Rat-Rig/V-Minion/README.md

# Rat Rig V-Minion

## Links
[CAD (Fusion 360)](https://a360.co/3rPymJS)

[Project Page](https://v-minion.ratrig.com/)

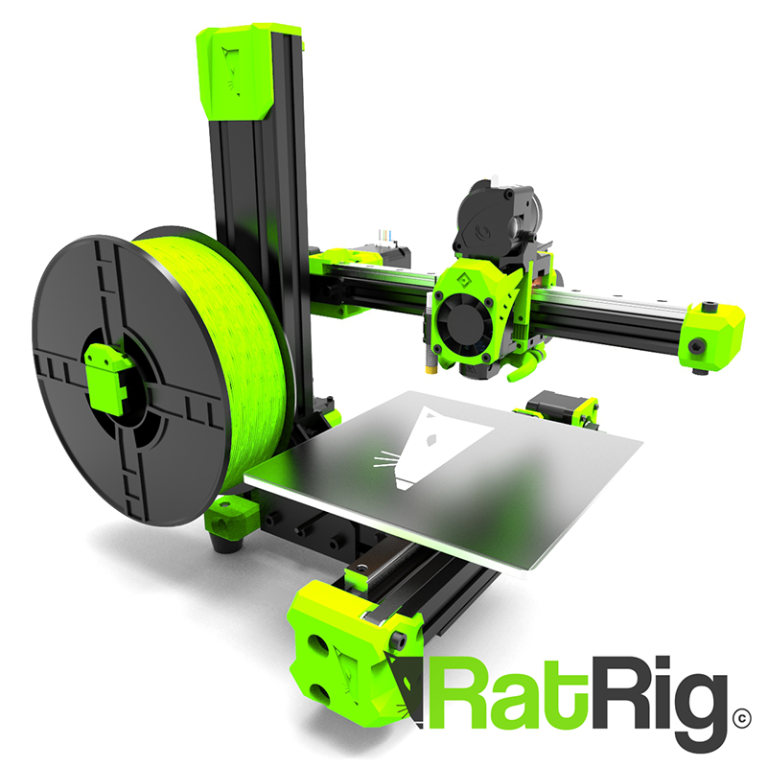
[picture p1: docs/src/assets/splash.png]
