Rat-Rig/V-Minion/cad/panels/README.md

# Electronics Enclosure panels

This subdirectory contains the source files for the four panels used on the V-Minion electronics enclosure.

# Formats
## DXF
For laser cutting, industry standard DXF files are provided. Both metric (millimeters) and imperial (inches) versions are available.

> **Please note:** The dimensions in the DXF files are exact. No provision for laser kerf has been provided as this varies greatly depending on the material being cut, the laser cutter being used, and / or the operator of the machine.

## STEP
For CNC routing, or CAD applications, industry standard STEP files are provided. Both metric (millimeters) and imperial (inches) versions are available.

## STL
For 3D printing your own panels. Metric (millimeters) versions are available.
