Rat-Rig/V-Minion/docs/src/electronics.md

---
title: Electronics
hide:
  - navigation
---

The default V-Minion configuration comes supplied with either an SKRat 1.0, SKR2, or Octopus 1.1 mainboards from BIGTREETECH. Rat Rig provide detailed wiring diagrams for these configurations.

## BIGTREETECH SKRat 1.0 Wiring Diagram

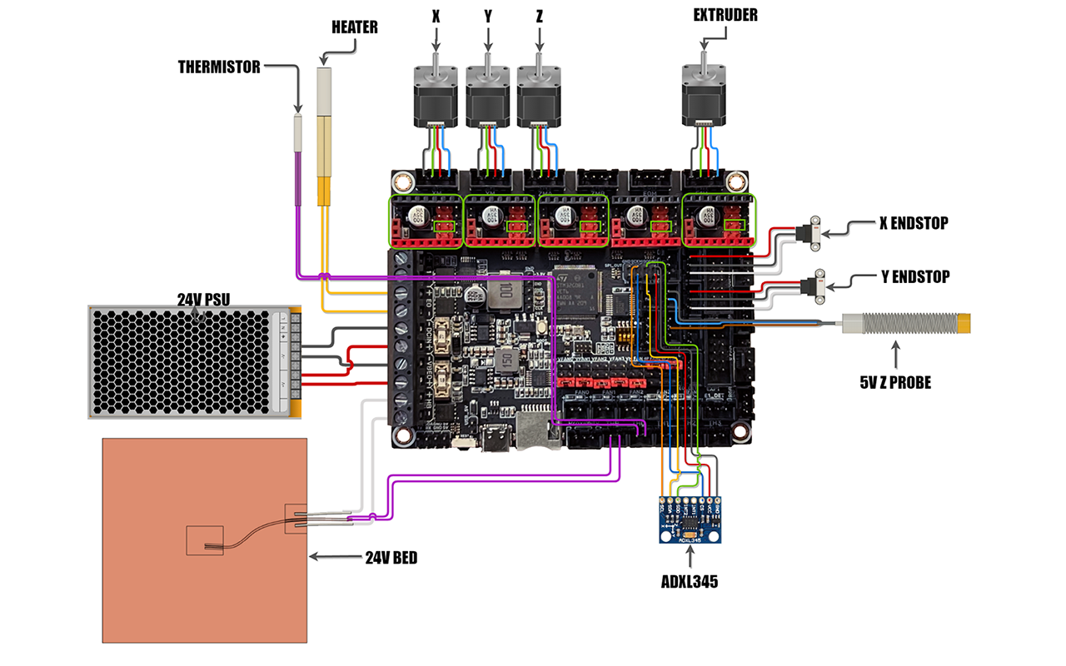
[picture p2: docs/src/assets/wiring_skrat_thumb.png]


<center>[:material-magnify-plus: Click here to view the full size wiring diagram](/assets/wiring_skrat.png){: .md-button .md-button--primary target=_blank}</center>

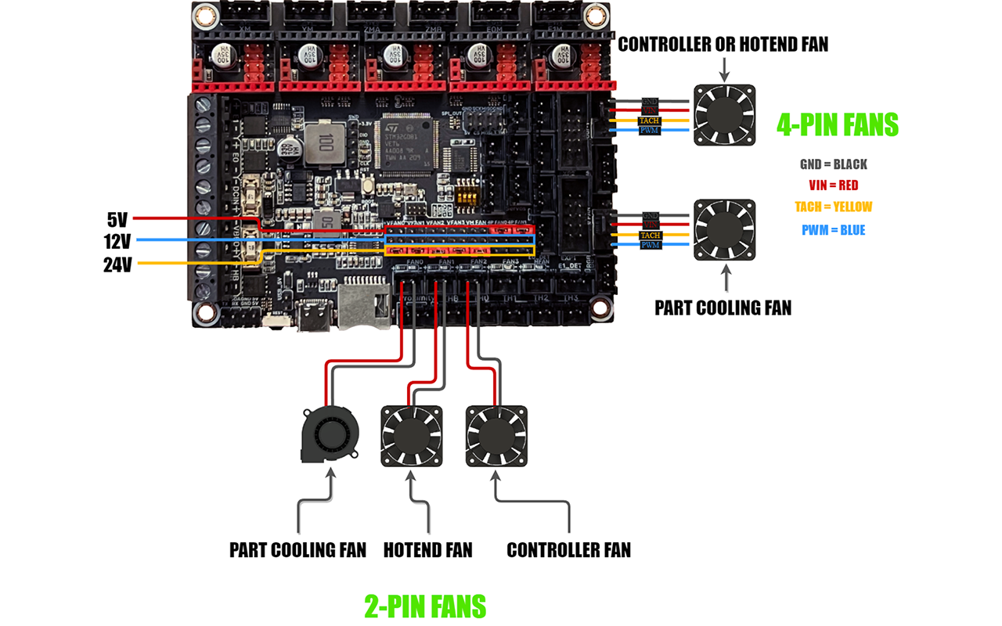
[picture p3: docs/src/assets/wiring_skrat_fan_thumb.png]


<center>[:material-magnify-plus: Click here to view the full size wiring diagram](/assets/wiring_skrat_fan.png){: .md-button .md-button--primary target=_blank}</center>

## BIGTREETECH Octopus 1.1 Wiring Diagram

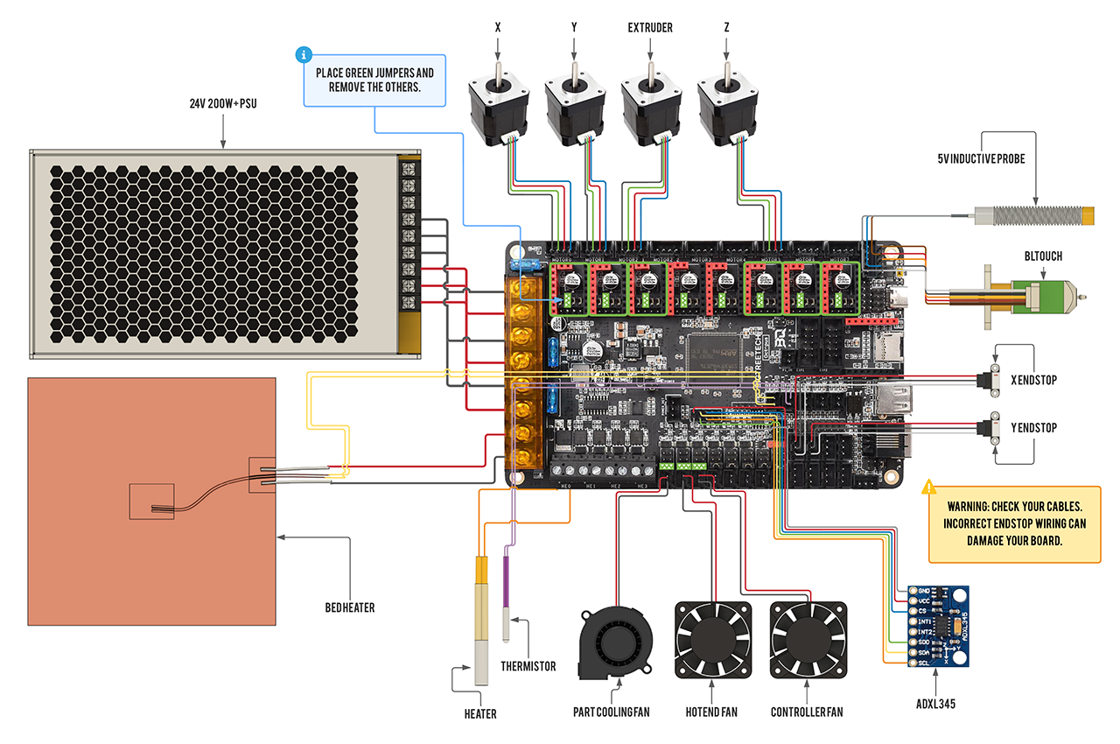
[picture p4: docs/src/assets/wiring_octopus_thumb.png]


<center>[:material-magnify-plus: Click here to view the full size wiring diagram](/assets/wiring_octopus.png){: .md-button .md-button--primary target=_blank}</center>

## BIGTREETECH SKR2 Wiring Diagram

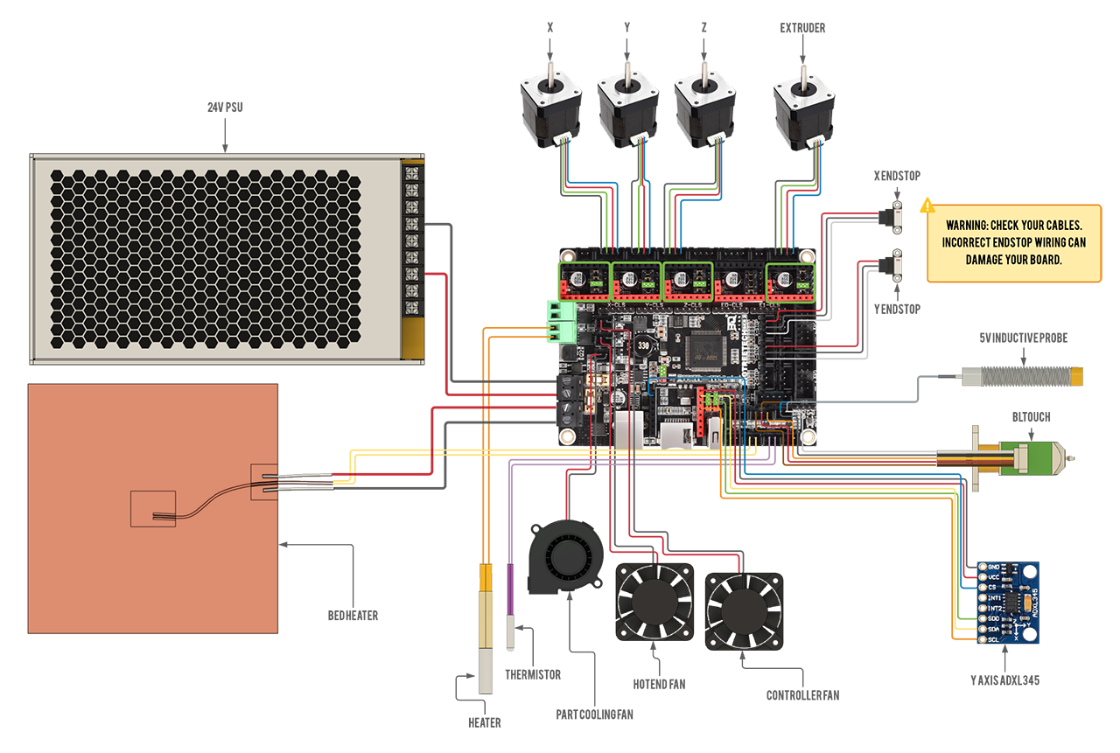
[picture p5: docs/src/assets/wiring_skr2_thumb.png]


<center>[:material-magnify-plus: Click here to view the full size wiring diagram](/assets/wiring_skr2.png){: .md-button .md-button--primary target=_blank}</center>

## Powering the Raspberry Pi from the SKR2
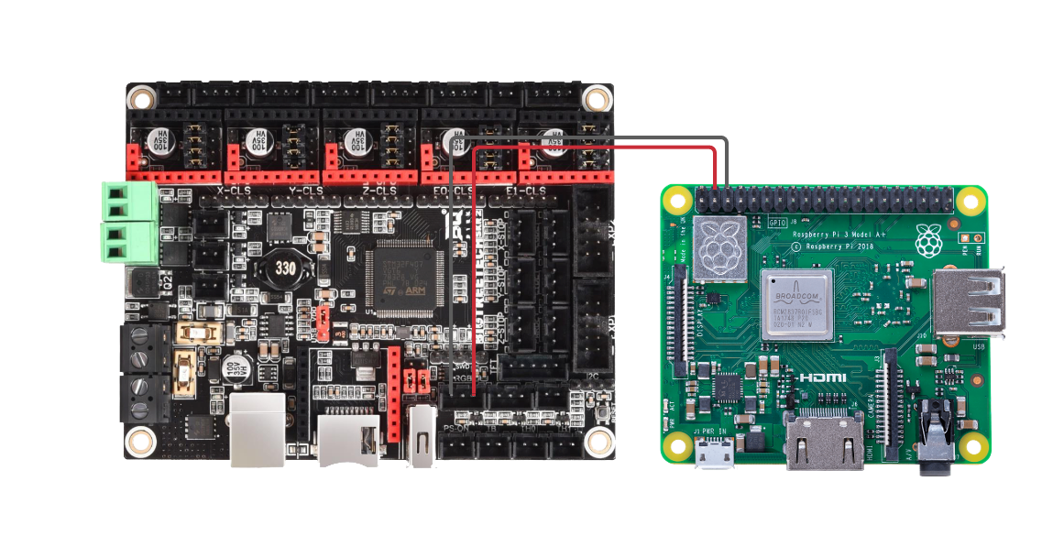
[picture p6: docs/src/assets/wiring_skr2_pi_power.png]
