Rat-Rig/V-Minion/docs/src/slicer.md

---
title: Slicer
hide:
  - navigation
---

## SuperSlicer
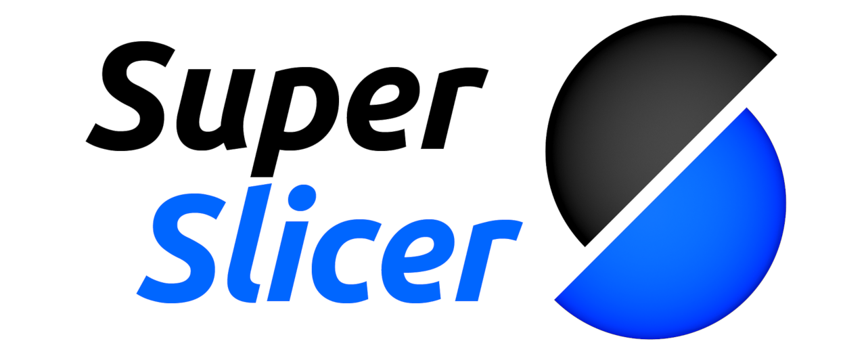
[picture p25: docs/src/assets/superslicer_logo.png]

Detlev Rackow, a member of Rat Rig's Beta/Dev team, provides SuperSlicer profiles for the V-Minion in its stock configuration. As of version 2.3.57 these profiles are not included with SuperSlicer, and must be installed manually, but are planned to be intergrated in a future version.

### Obtaining SuperSlicer
SuperSlicer is a free and open-source project. It can be obtained directly from their [:material-github: GitHub repository](https://github.com/supermerill/SuperSlicer/releases)

### Configuring SuperSlicer for the V-Minion
The following video gives an overview on configuring SuperSlicer to connect with your V-Minion:
<center><iframe width="1000" height="600" src="https://www.youtube.com/embed/5o2UqtdWnn0" frameborder="0" allow="accelerometer; autoplay; clipboard-write; encrypted-media; gyroscope; picture-in-picture" allowfullscreen></iframe></center>
