Rat-Rig/V-Minion/docs/src/firmware.md

---
title: Firmware
hide:
  - navigation
---

## RatOS
RatOS is developed and maintained by Mikkel Schmidt (a member of Rat Rig's Beta/Dev team). It combines the power of the Klipper firmware, as well as several other open-source projects, to provide a stable and easy-to-use operating system for all your printing needs.
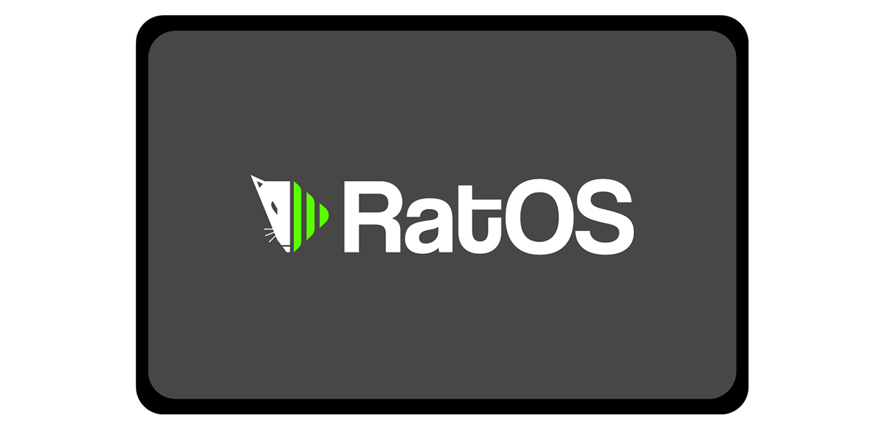
[picture p26: docs/src/assets/ratos_logo.png]


<center>[:material-link-box-variant: Official RatOS documentation](https://os.ratrig.com/){: .md-button .md-button--primary}</center>
