Rat-Rig/V-Minion/docs/src/assets/360/main/1.png

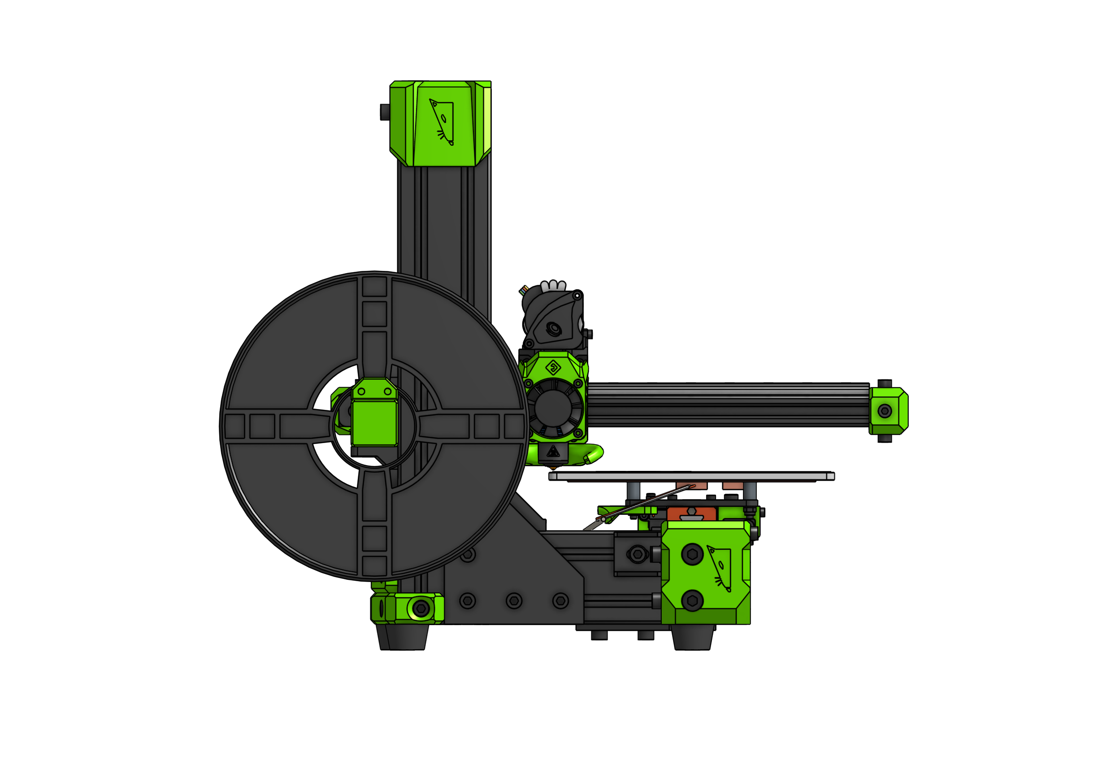
docs/src/assets/360/main/1.png
