Rat-Rig/V-Minion/docs/src/assets/360/main/3.png

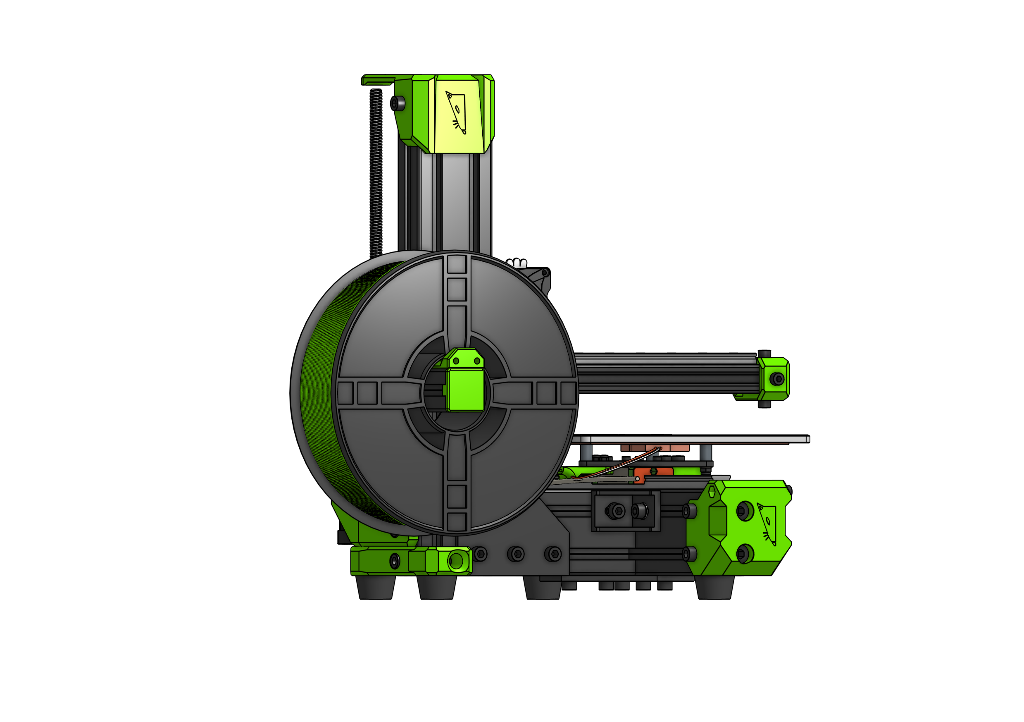
docs/src/assets/360/main/3.png
