Rat-Rig/V-Minion/docs/src/assets/360/main/4.png

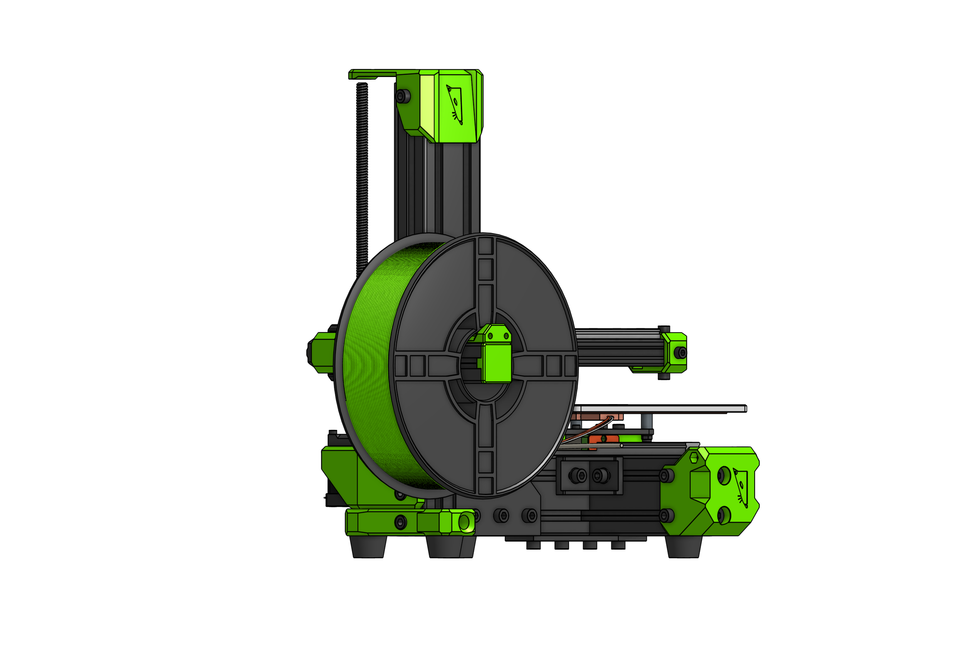
docs/src/assets/360/main/4.png
