Rat-Rig/V-Minion/docs/src/assets/360/main/5.png

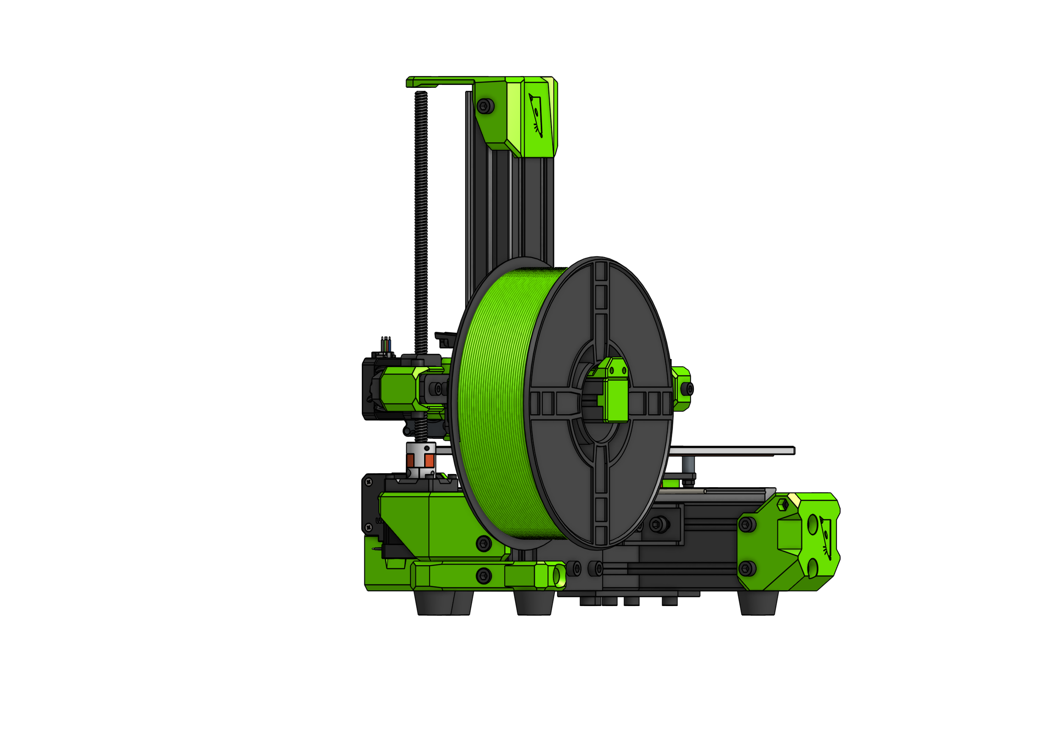
docs/src/assets/360/main/5.png
