Rat-Rig/V-Minion/docs/src/assets/360/main/6.png

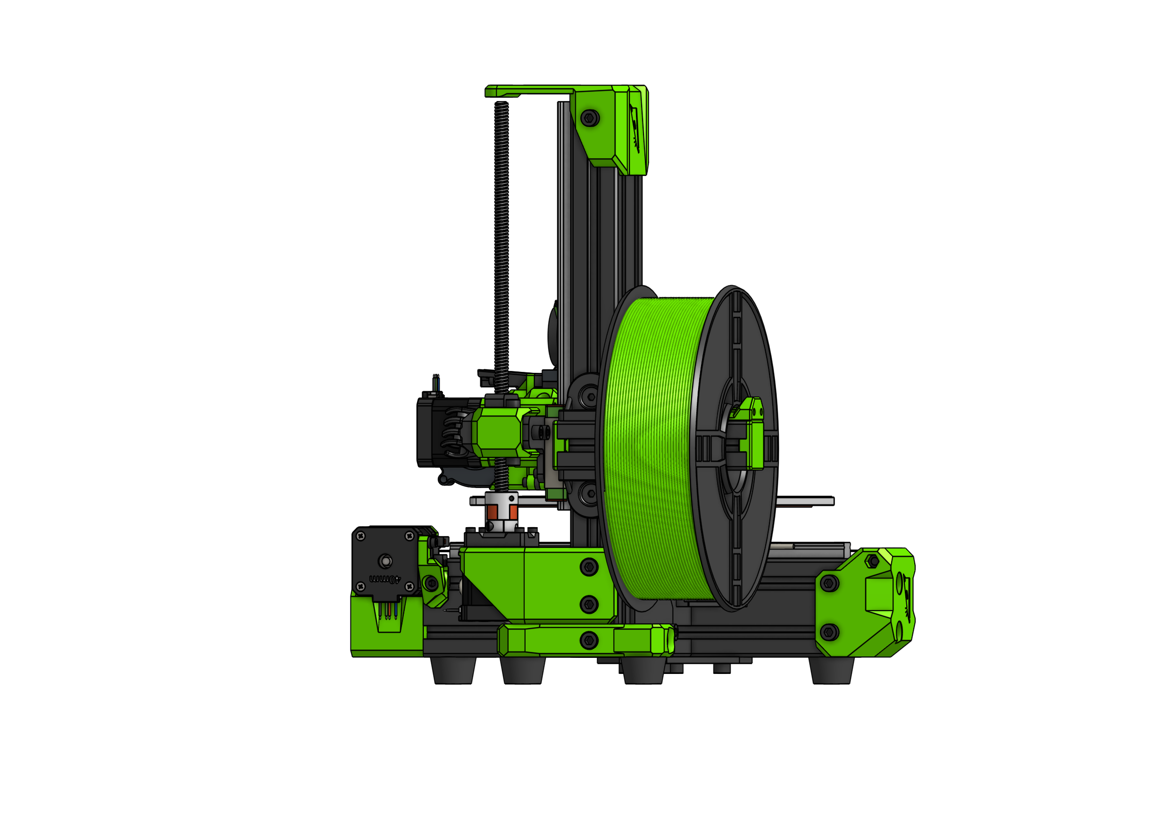
docs/src/assets/360/main/6.png
