Rat-Rig/V-Minion/docs/src/assets/360/main/7.png

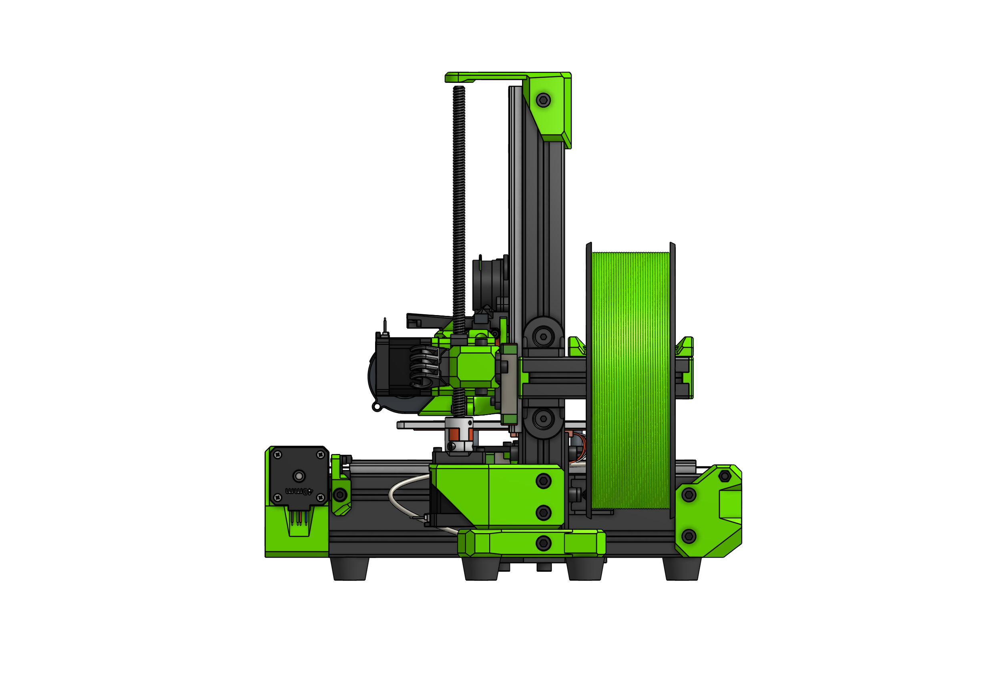
docs/src/assets/360/main/7.png
