Rat-Rig/V-Minion/docs/src/assets/360/main/8.png

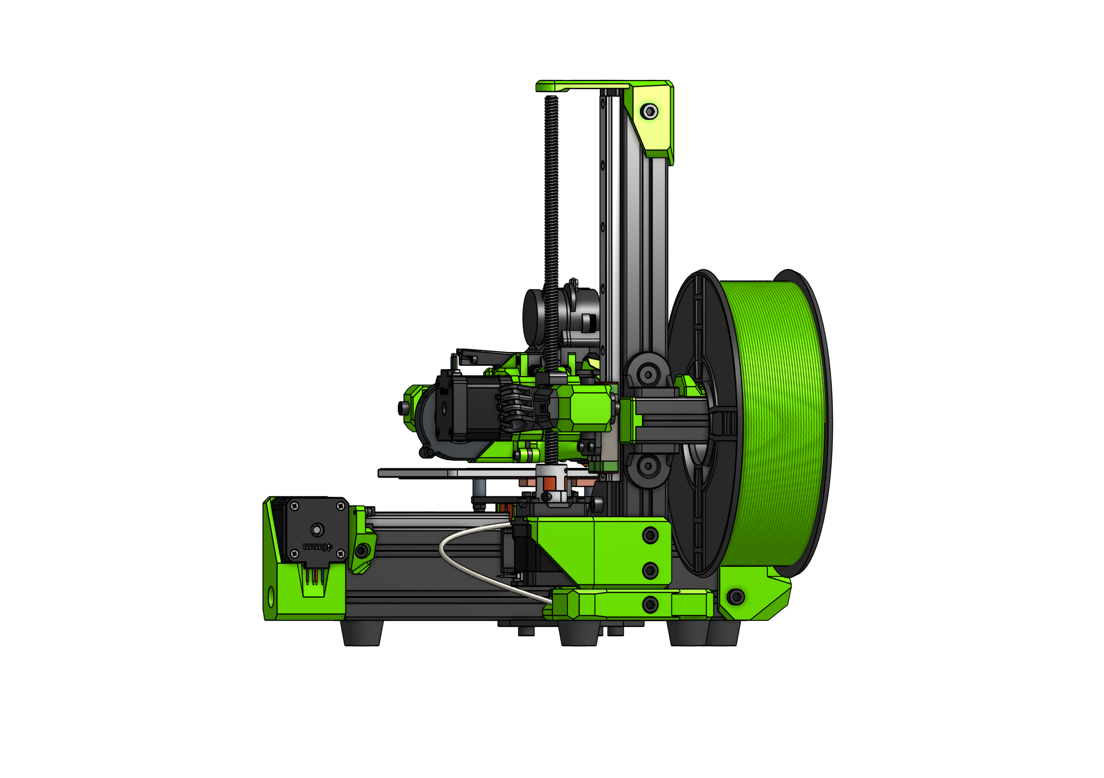
docs/src/assets/360/main/8.png
