Rat-Rig/V-Minion/docs/src/assets/360/main/9.png

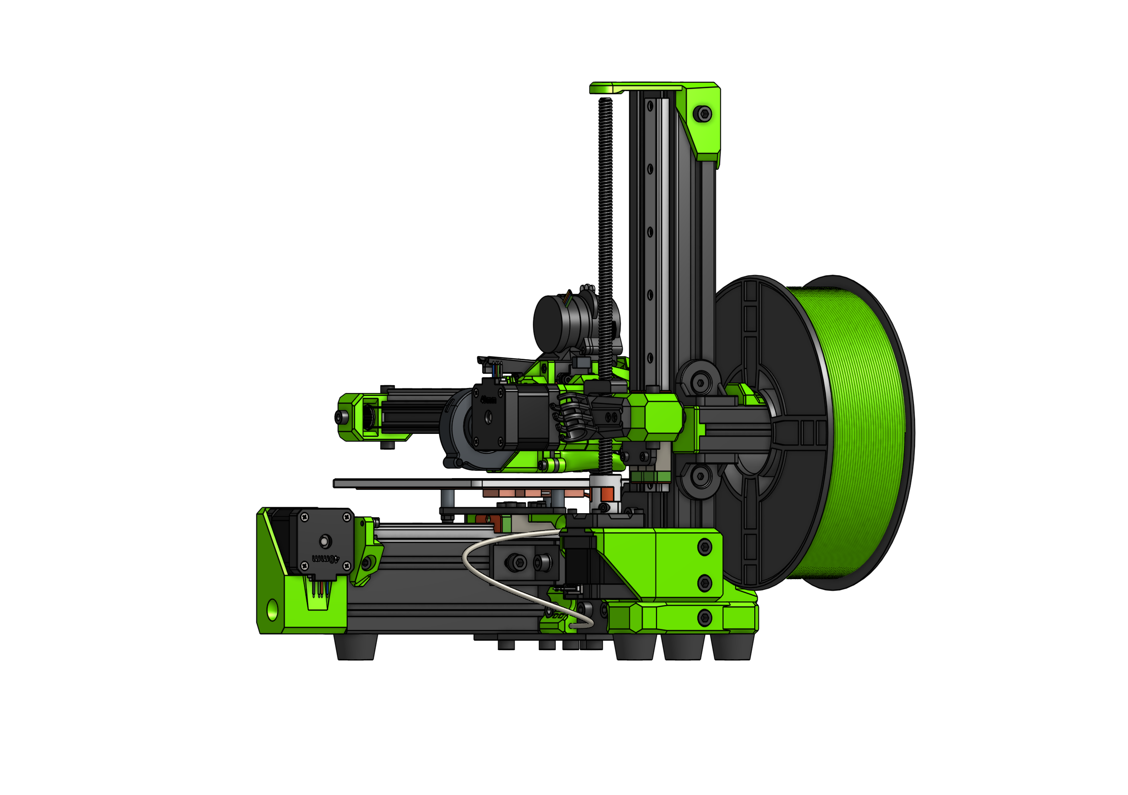
docs/src/assets/360/main/9.png
