Rat-Rig/V-Minion/docs/src/assets/360/main/10.png

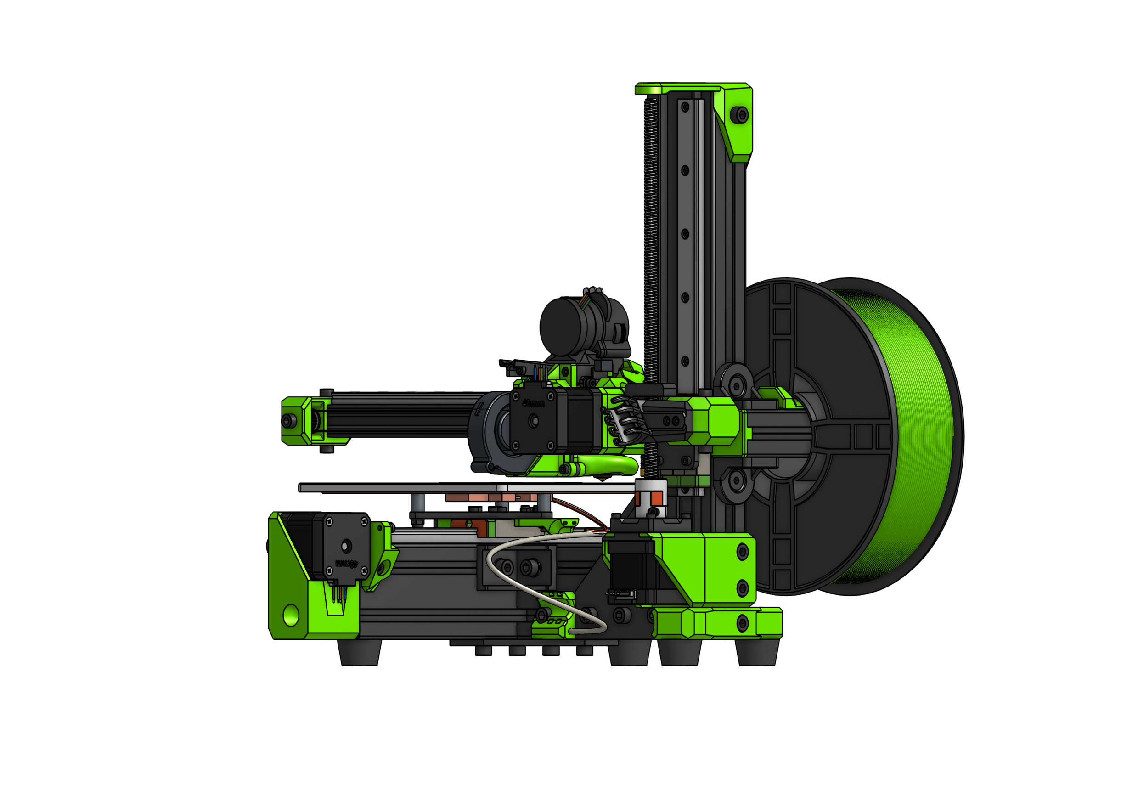
docs/src/assets/360/main/10.png
