Rat-Rig/V-Minion/docs/src/assets/360/main/11.png

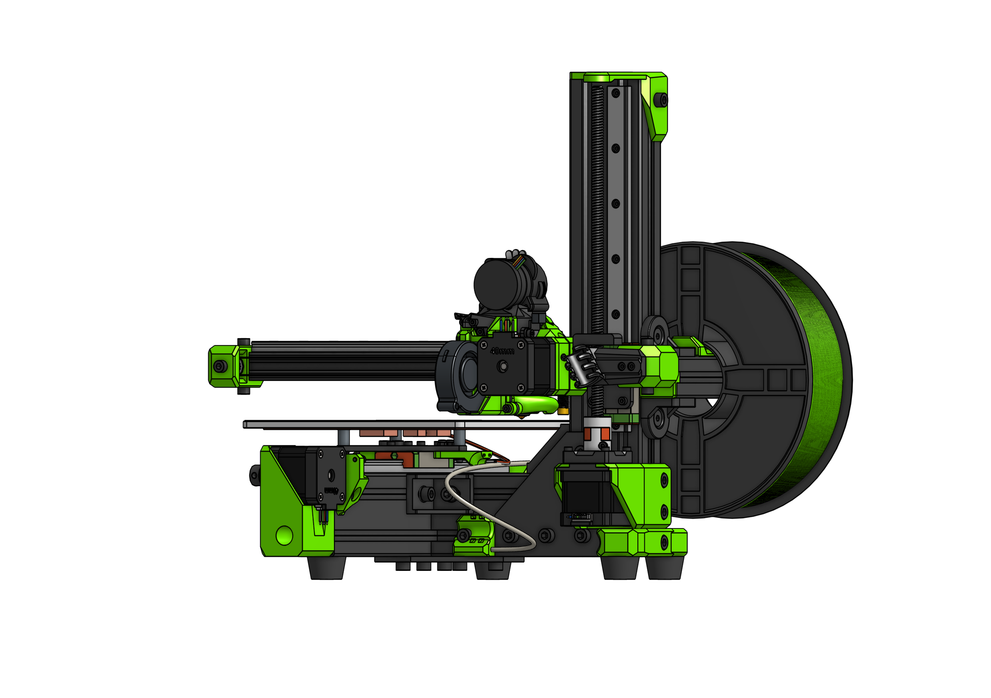
docs/src/assets/360/main/11.png
