Rat-Rig/V-Minion/docs/src/assets/360/main/12.png

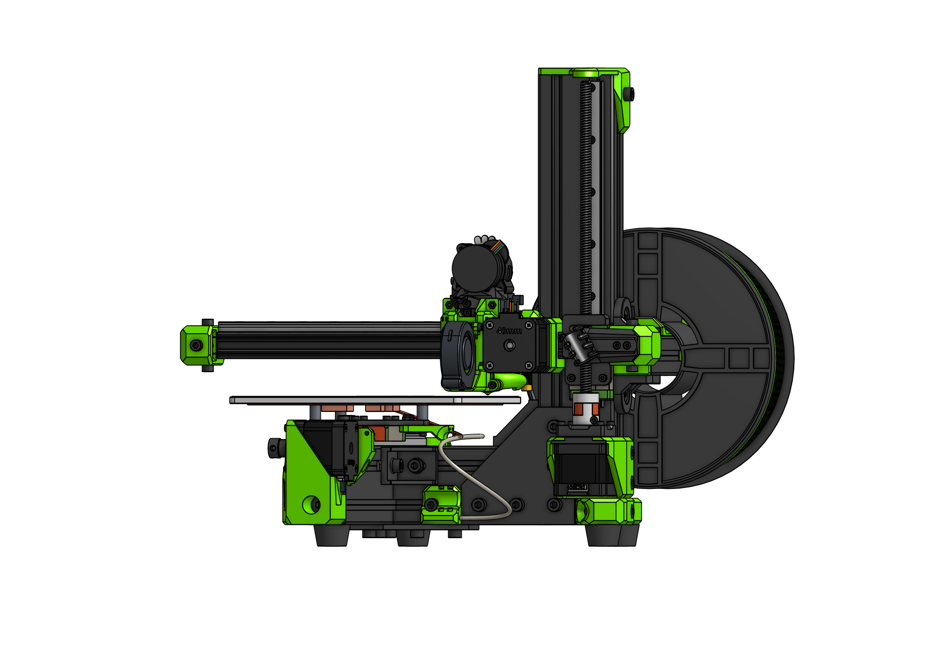
docs/src/assets/360/main/12.png
