Rat-Rig/V-Minion/docs/src/assets/360/main/14.png

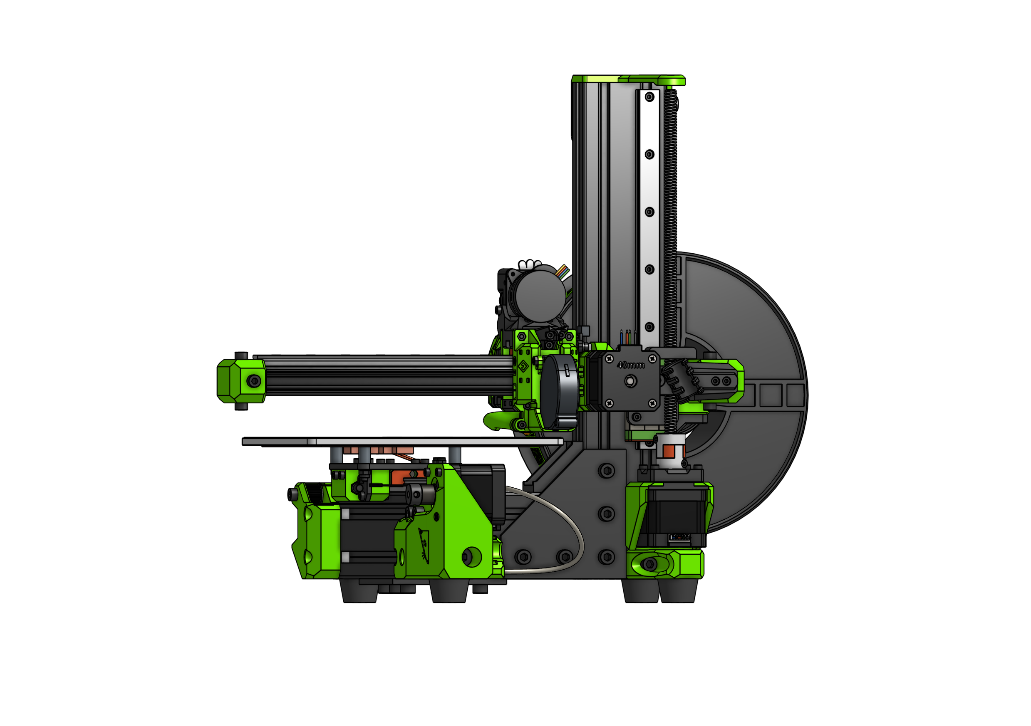
docs/src/assets/360/main/14.png
