Rat-Rig/V-Minion/docs/src/assets/360/main/16.png

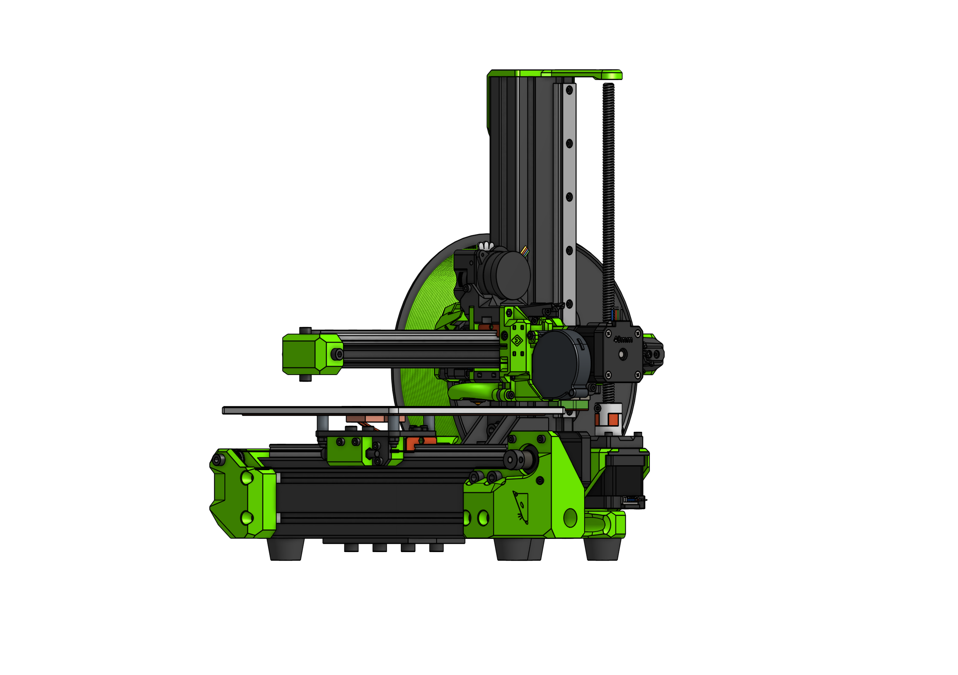
docs/src/assets/360/main/16.png
