Rat-Rig/V-Minion/docs/src/assets/360/main/17.png

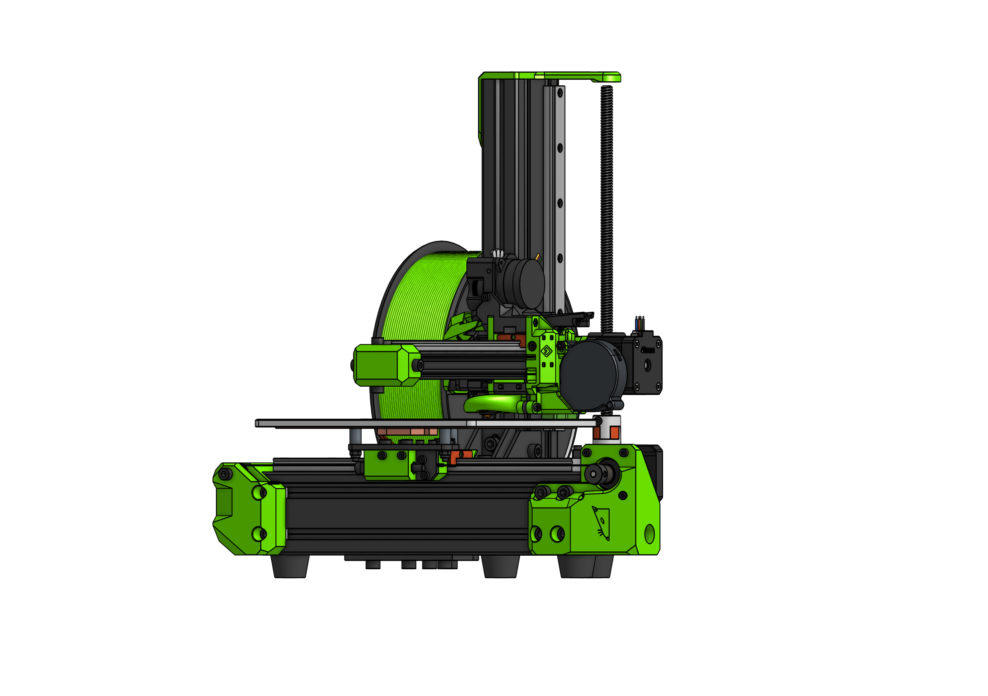
docs/src/assets/360/main/17.png
