Rat-Rig/V-Minion/docs/src/assets/360/main/20.png

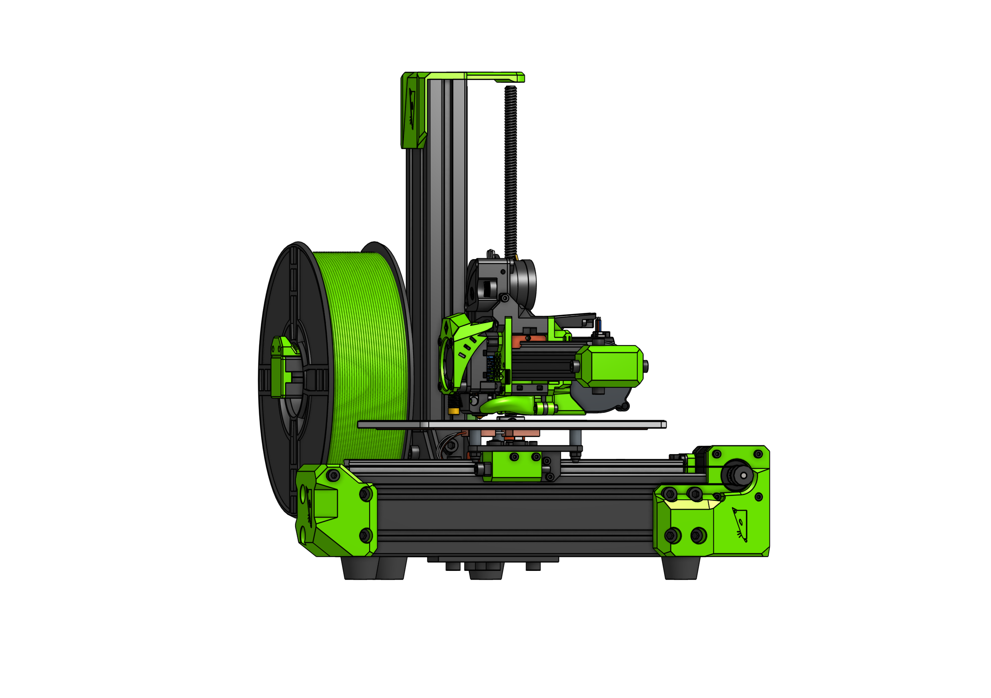
docs/src/assets/360/main/20.png
