Rat-Rig/V-Minion/docs/src/assets/360/main/21.png

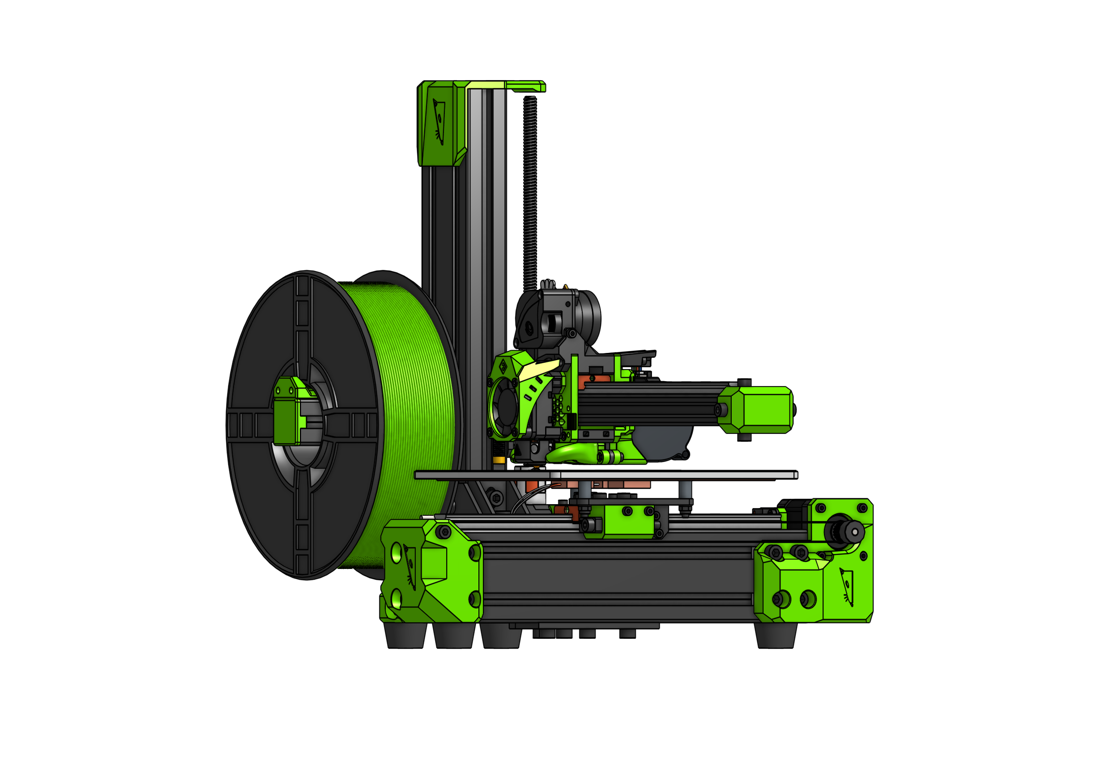
docs/src/assets/360/main/21.png
