Rat-Rig/V-Minion/docs/src/assets/360/main/22.png

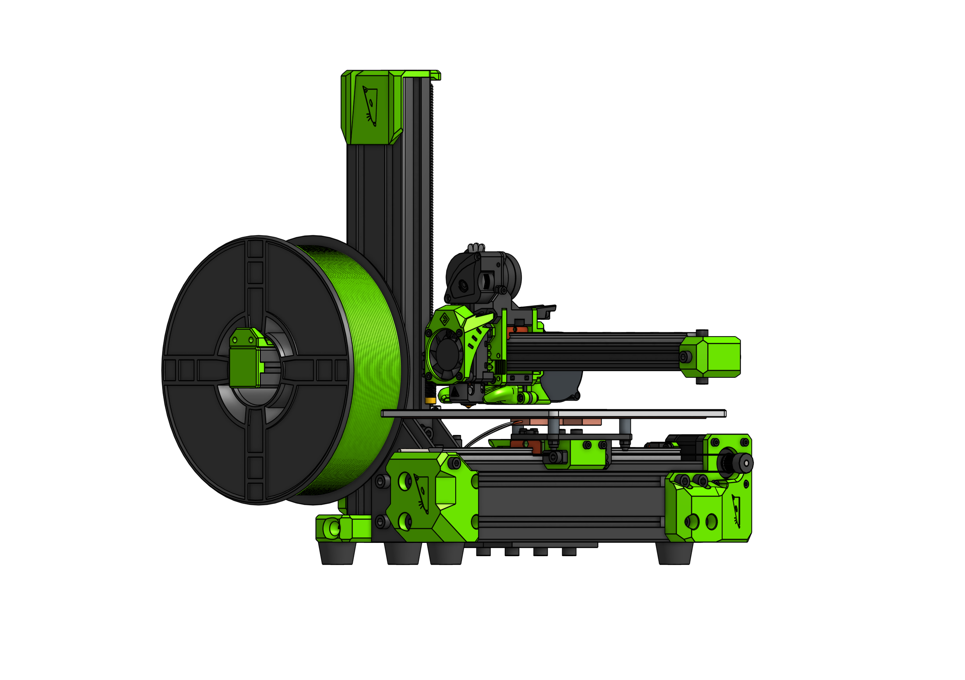
docs/src/assets/360/main/22.png
