Rat-Rig/V-Minion/docs/src/assets/360/printed_parts/13.png

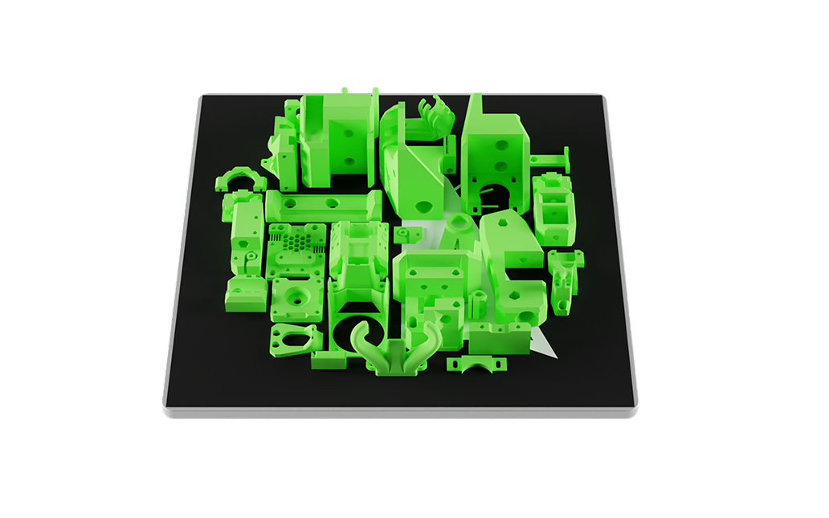
docs/src/assets/360/printed_parts/13.png
