Rat-Rig/V-Minion/docs/src/assets/360/printed_parts/17.png

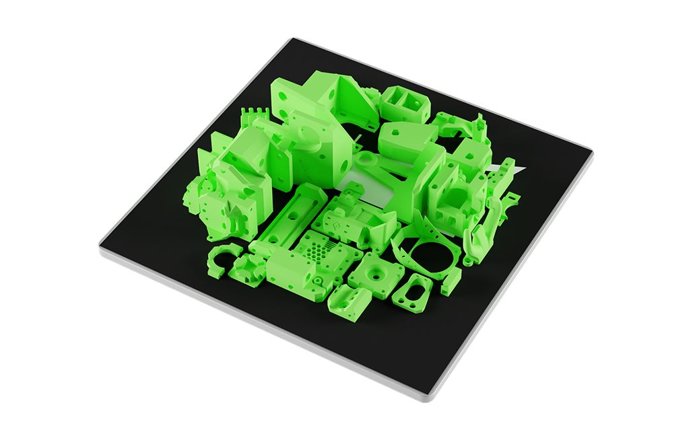
docs/src/assets/360/printed_parts/17.png
