Rat-Rig/V-Minion/cad/panels/STEP/Imperial/panel_electronics_psu_v1.0.step

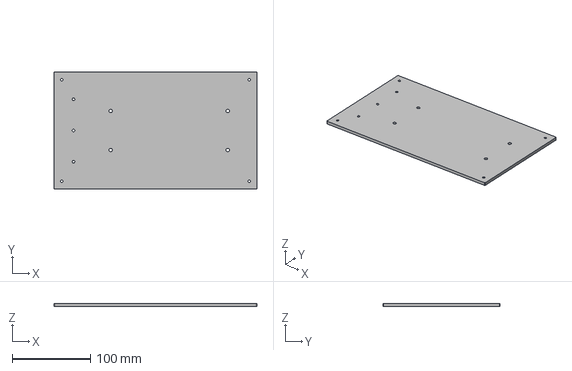
[picture p69: CAD file, 2022-02-11]
cad/panels/STEP/Imperial/panel_electronics_psu_v1.0.step
260.0 x 150.0 x 4.00 mm
