Rat-Rig/V-Minion/cad/printed_parts/elecronics_case/step/case_wire_holder.step

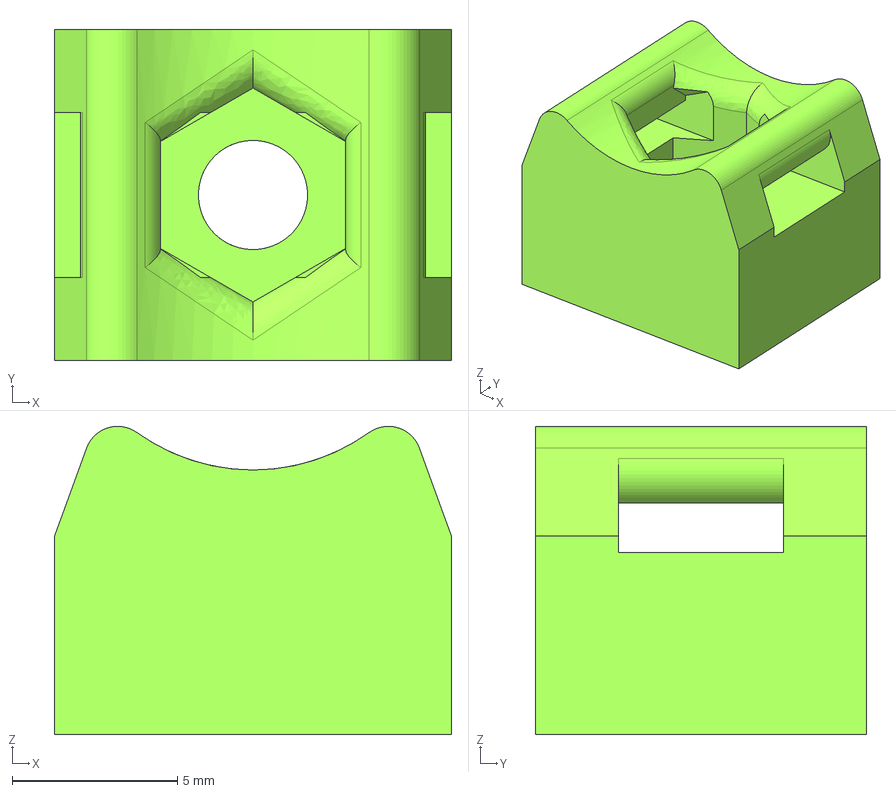
[picture p70: CAD file, 2021-12-29]
cad/printed_parts/elecronics_case/step/case_wire_holder.step
12.0 x 10.0 x 9.32 mm
