Rat-Rig/V-Minion/cad/printed_parts/machine/step/ratrig_eva_shroud.step

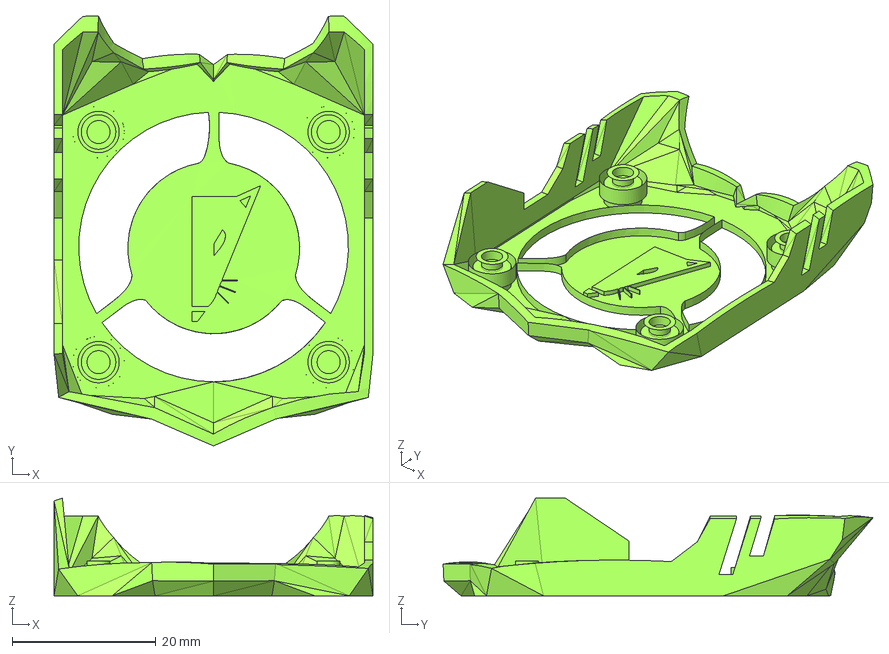
[picture p71: CAD file, 2022-10-20]
cad/printed_parts/machine/step/ratrig_eva_shroud.step
44.4 x 59.8 x 13.6 mm
