Rat-Rig/V-Minion/cad/panels/STEP/Metric/panel_electronics_top_v1.0.step

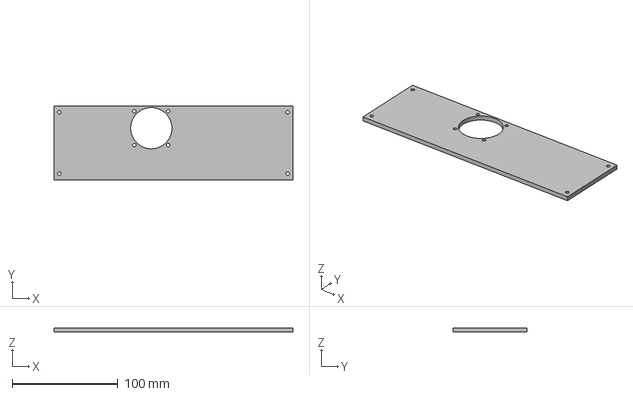
[picture p72: CAD file, 2022-02-11]
cad/panels/STEP/Metric/panel_electronics_top_v1.0.step
226.0 x 70.0 x 4.00 mm
