Rat-Rig/V-Minion/cad/panels/STL/panel_electronics_base_v1.0.stl

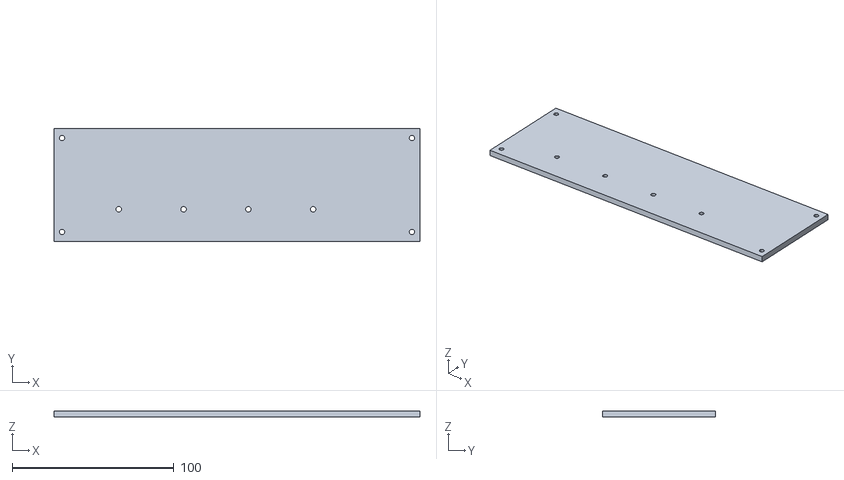
[picture p73: CAD file, 2022-02-11]
cad/panels/STL/panel_electronics_base_v1.0.stl
226.0 x 70.0 x 4.00
