Rat-Rig/V-Minion/cad/printed_parts/elecronics_case/step/case_wire_passthrough.step

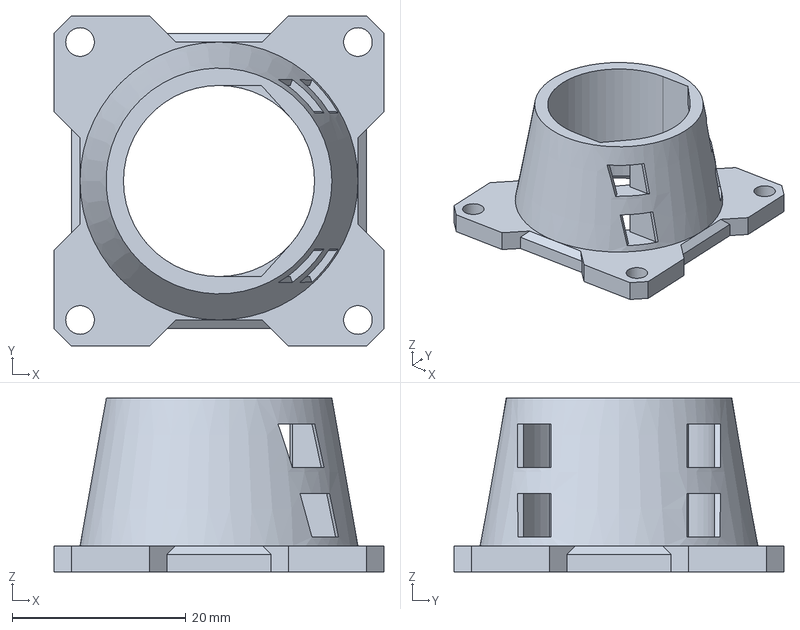
[picture p74: CAD file, 2021-12-29]
cad/printed_parts/elecronics_case/step/case_wire_passthrough.step
38.0 x 38.0 x 20.0 mm
