Rat-Rig/V-Minion/cad/printed_parts/machine/step/3030_end_cap.step

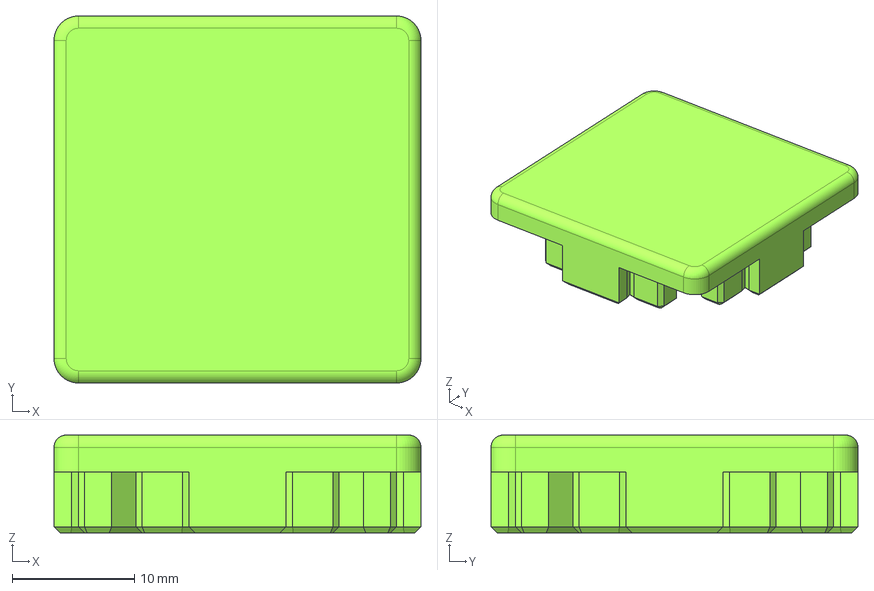
[picture p75: CAD file, 2021-12-30]
cad/printed_parts/machine/step/3030_end_cap.step
30.0 x 30.0 x 8.00 mm
