Rat-Rig/V-Minion/cad/printed_parts/elecronics_case/step/case_front.step

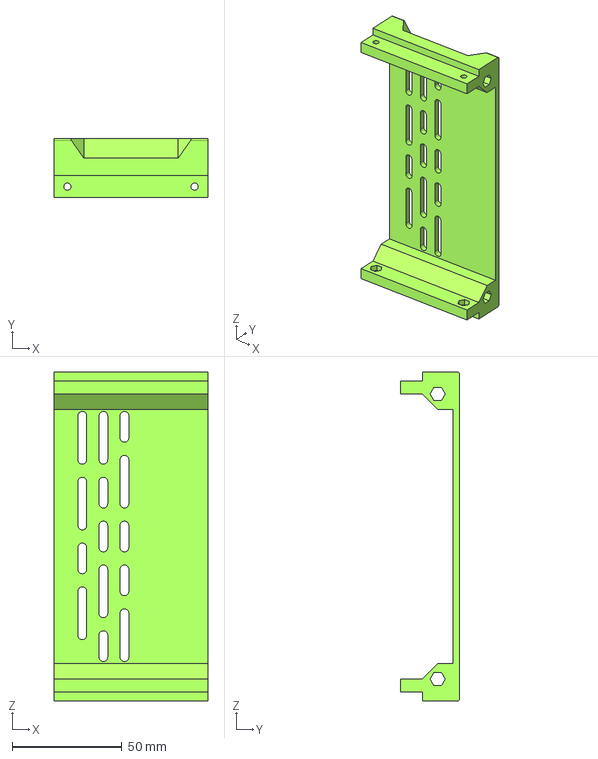
[picture p76: CAD file, 2021-12-29]
cad/printed_parts/elecronics_case/step/case_front.step
70.0 x 27.0 x 150.0 mm
