Rat-Rig/V-Minion/cad/printed_parts/machine/step/3030 Spool Holder Mount.step

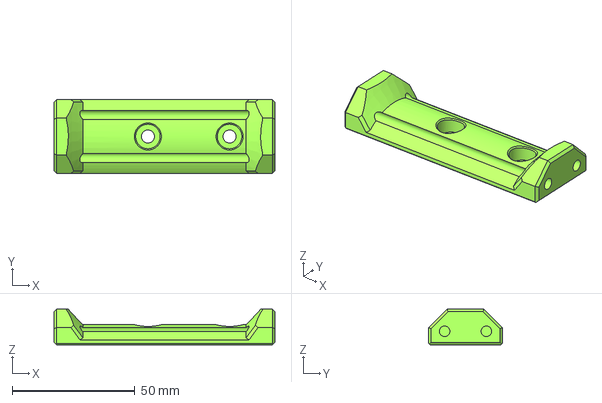
[picture p77: CAD file, 2021-12-30]
cad/printed_parts/machine/step/3030 Spool Holder Mount.step
90.0 x 30.0 x 14.5 mm
