Rat-Rig/V-Minion/cad/printed_parts/elecronics_case/step/case_feet.step

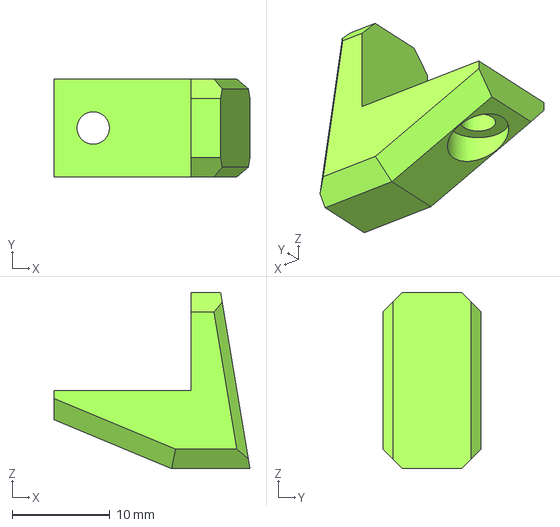
[picture p78: CAD file, 2021-12-29]
cad/printed_parts/elecronics_case/step/case_feet.step
20.0 x 10.0 x 18.0 mm
