Rat-Rig/V-Minion/cad/printed_parts/machine/step/bmo_face.step

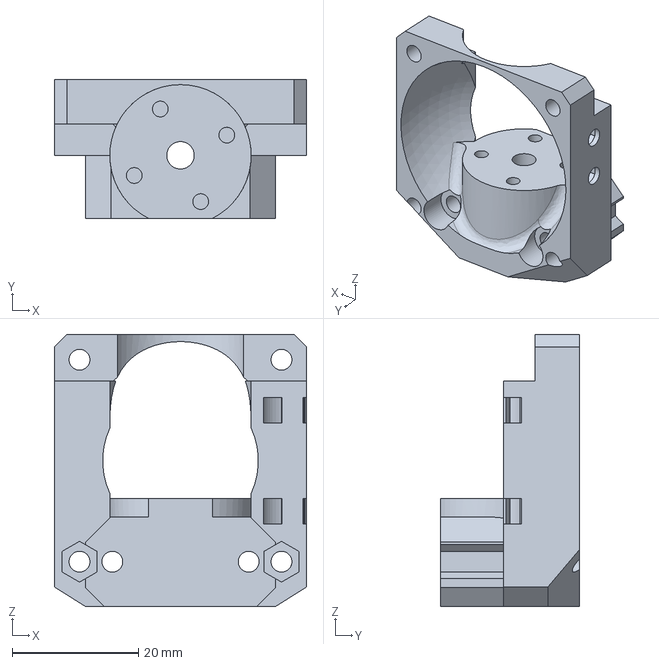
[picture p79: CAD file, 2021-12-29]
cad/printed_parts/machine/step/bmo_face.step
40.0 x 22.0 x 43.1 mm
