Rat-Rig/V-Minion/cad/printed_parts/elecronics_case/step/40mm_fan_cage.step

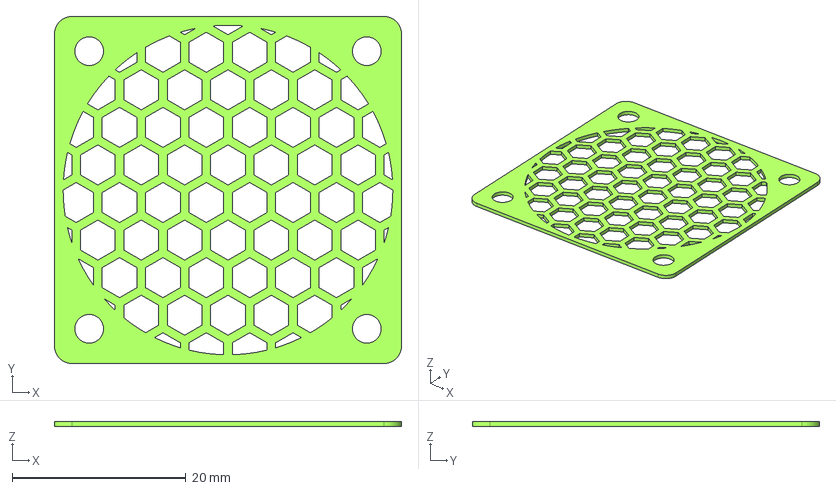
[picture p80: CAD file, 2021-12-29]
cad/printed_parts/elecronics_case/step/40mm_fan_cage.step
40.0 x 40.0 x 0.6 mm
