Rat-Rig/V-Minion/cad/printed_parts/machine/step/x_gantry_end_cap.step

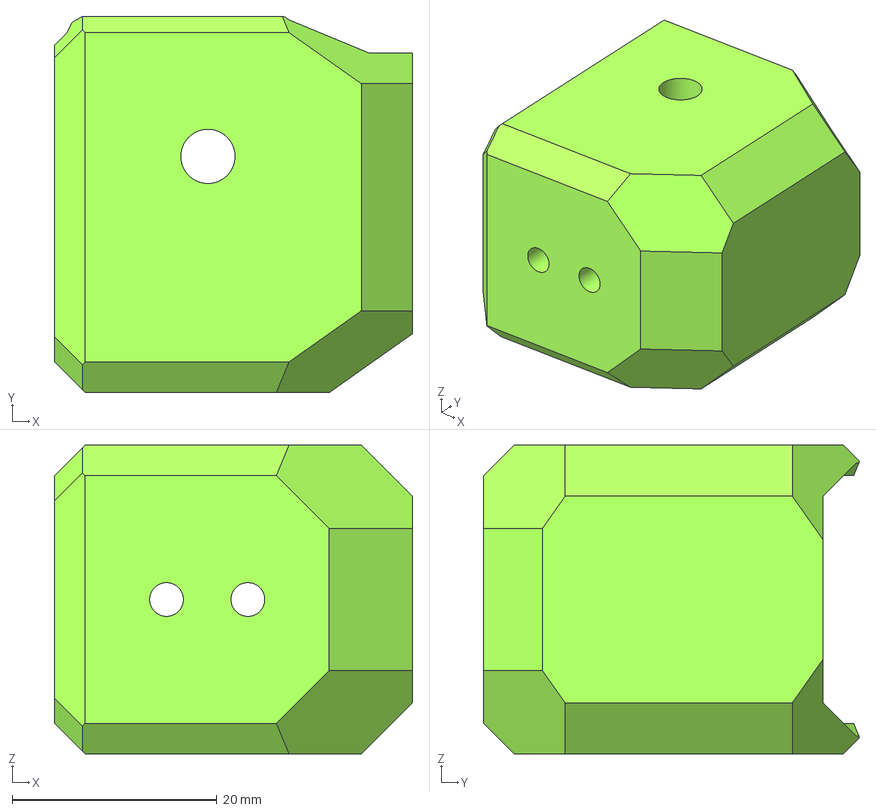
[picture p81: CAD file, 2021-12-29]
cad/printed_parts/machine/step/x_gantry_end_cap.step
35.0 x 36.8 x 30.2 mm
