Rat-Rig/V-Minion/cad/printed_parts/elecronics_case/step/case_back.step

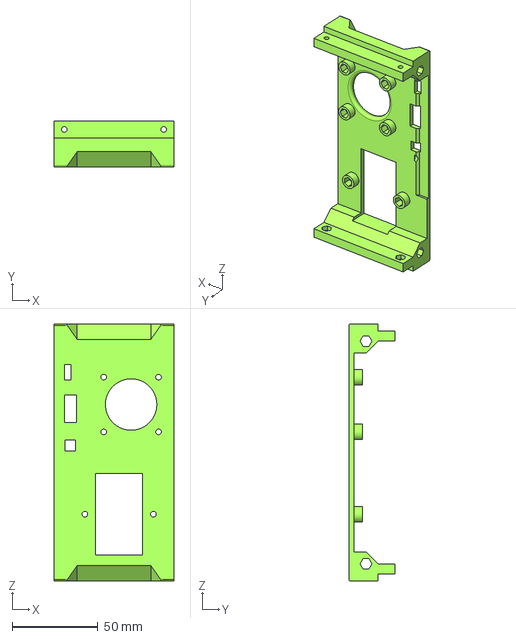
[picture p82: CAD file, 2021-12-29]
cad/printed_parts/elecronics_case/step/case_back.step
70.0 x 27.0 x 150.0 mm
