Rat-Rig/V-Minion/cad/printed_parts/machine/step/y_belt_tensioner.step

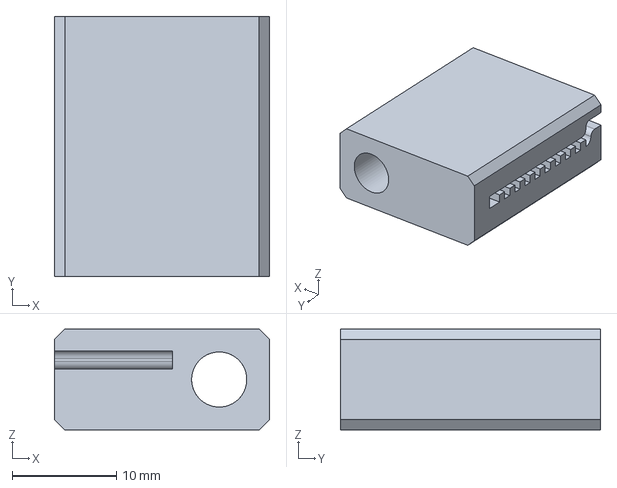
[picture p83: CAD file, 2021-12-29]
cad/printed_parts/machine/step/y_belt_tensioner.step
20.7 x 25.0 x 9.70 mm
