Rat-Rig/V-Minion/cad/printed_parts/machine/step/bmo_support.step

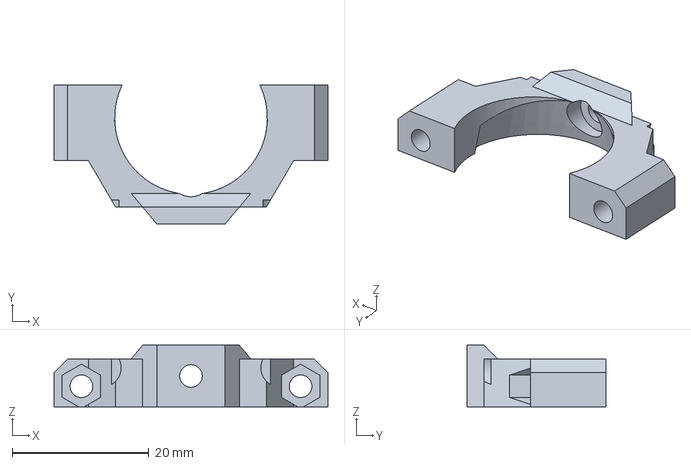
[picture p84: CAD file, 2021-12-29]
cad/printed_parts/machine/step/bmo_support.step
40.0 x 20.3 x 9.00 mm
