Rat-Rig/V-Minion/cad/printed_parts/machine/step/x_motor_cage.step

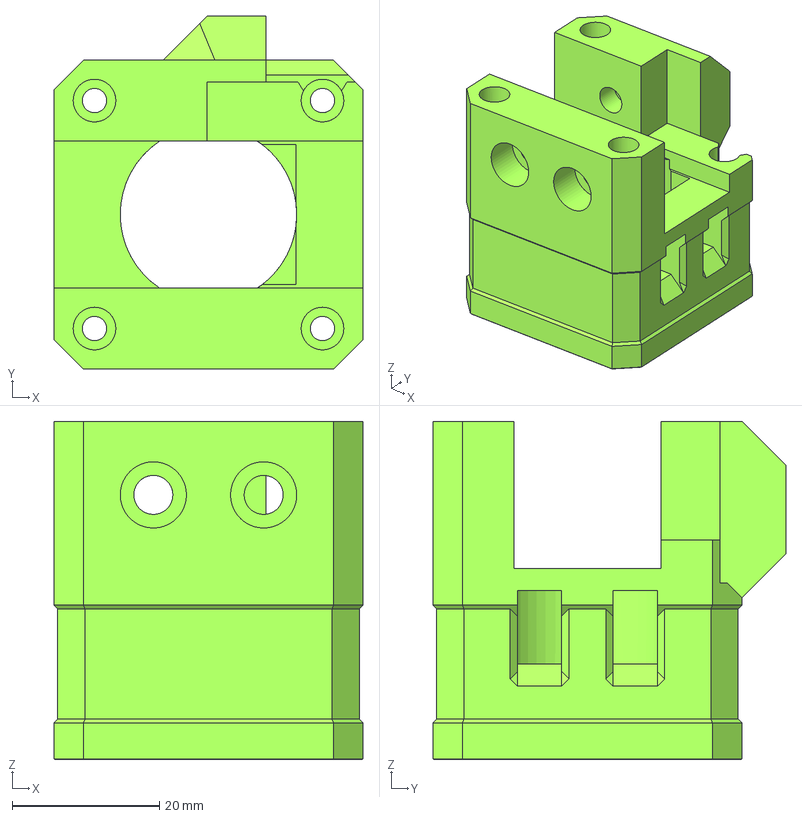
[picture p85: CAD file, 2021-12-29]
cad/printed_parts/machine/step/x_motor_cage.step
42.0 x 48.0 x 46.0 mm
