Rat-Rig/V-Minion/cad/printed_parts/machine/step/TriHorn Duct.step

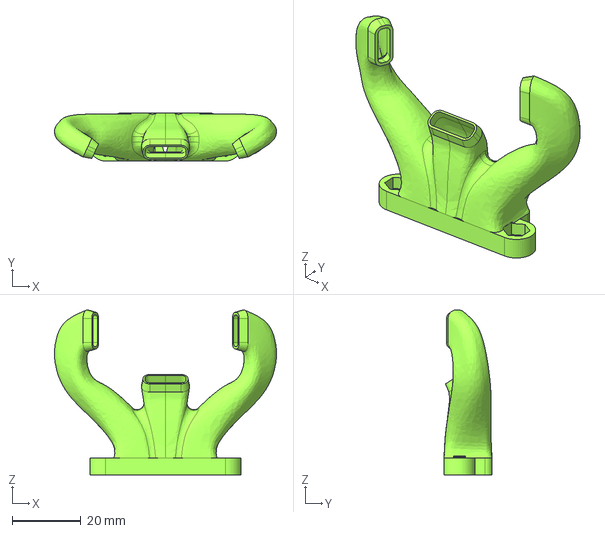
[picture p86: CAD file, 2021-12-29]
cad/printed_parts/machine/step/TriHorn Duct.step
64.6 x 14.0 x 48.0 mm
