Rat-Rig/V-Minion/cad/printed_parts/machine/step/universal_face.step

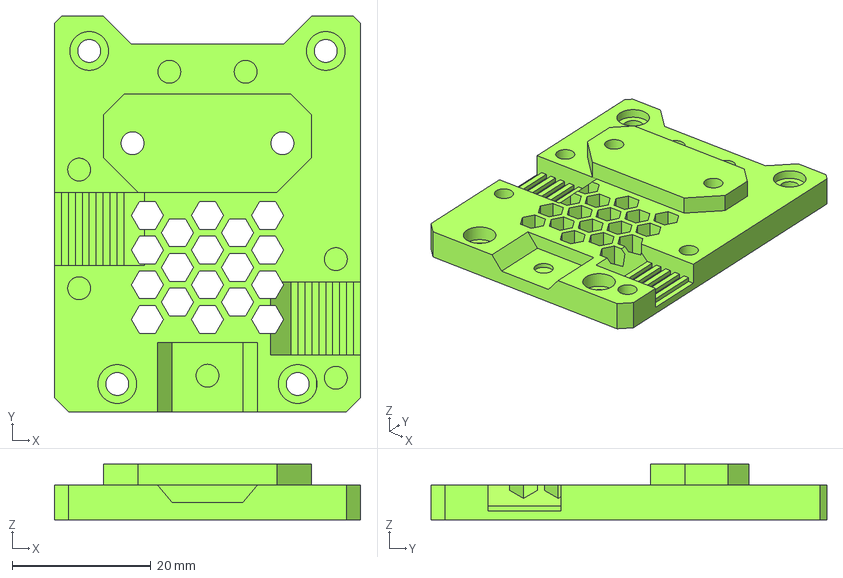
[picture p87: CAD file, 2021-12-29]
cad/printed_parts/machine/step/universal_face.step
44.1 x 57.0 x 8.00 mm
