Rat-Rig/V-Minion/cad/printed_parts/machine/step/y_motor_cage.step

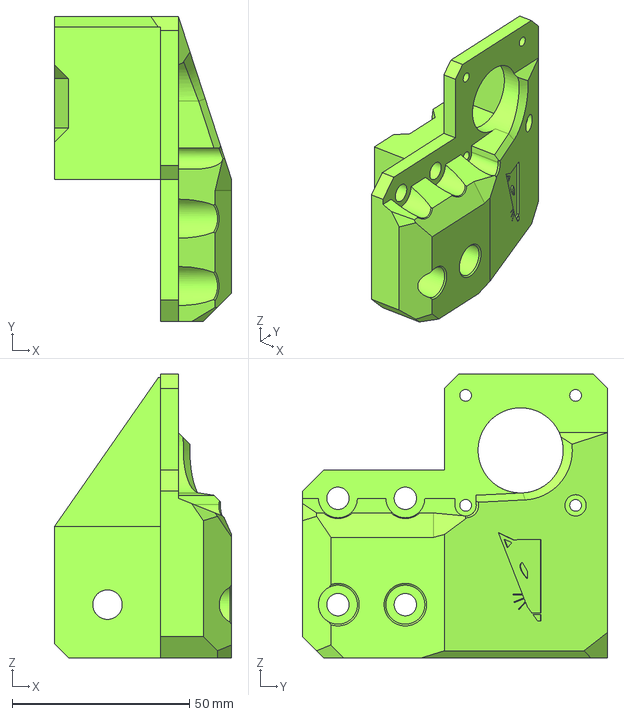
[picture p88: CAD file, 2021-12-29]
cad/printed_parts/machine/step/y_motor_cage.step
50.0 x 86.0 x 80.0 mm
