Rat-Rig/V-Minion/cad/printed_parts/machine/step/tension_slider_6mm_belt_M3s.step

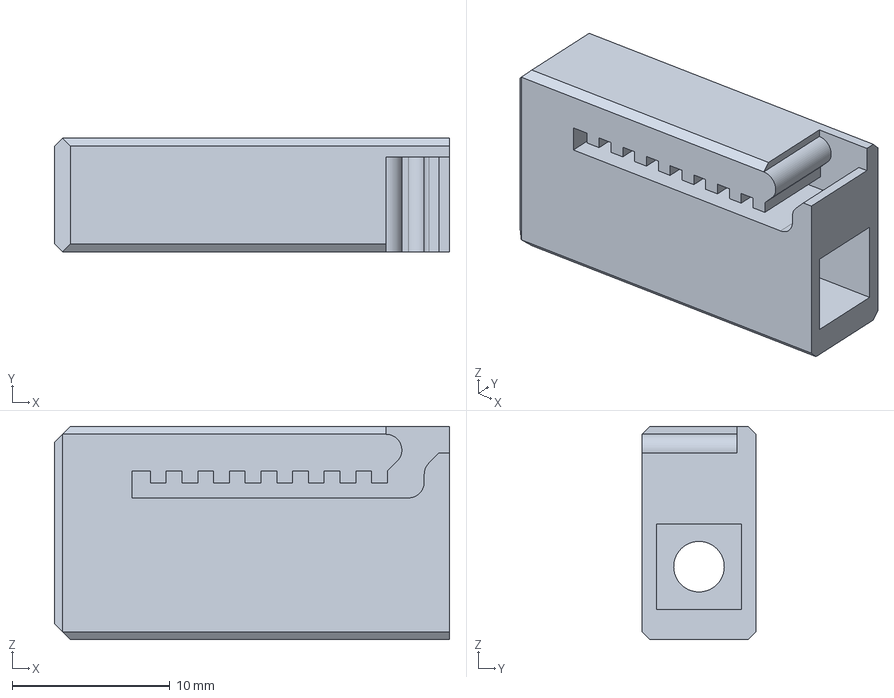
[picture p89: CAD file, 2021-12-29]
cad/printed_parts/machine/step/tension_slider_6mm_belt_M3s.step
25.0 x 7.20 x 13.5 mm
