Rat-Rig/V-Minion/cad/printed_parts/machine/step/back_cartesian.step

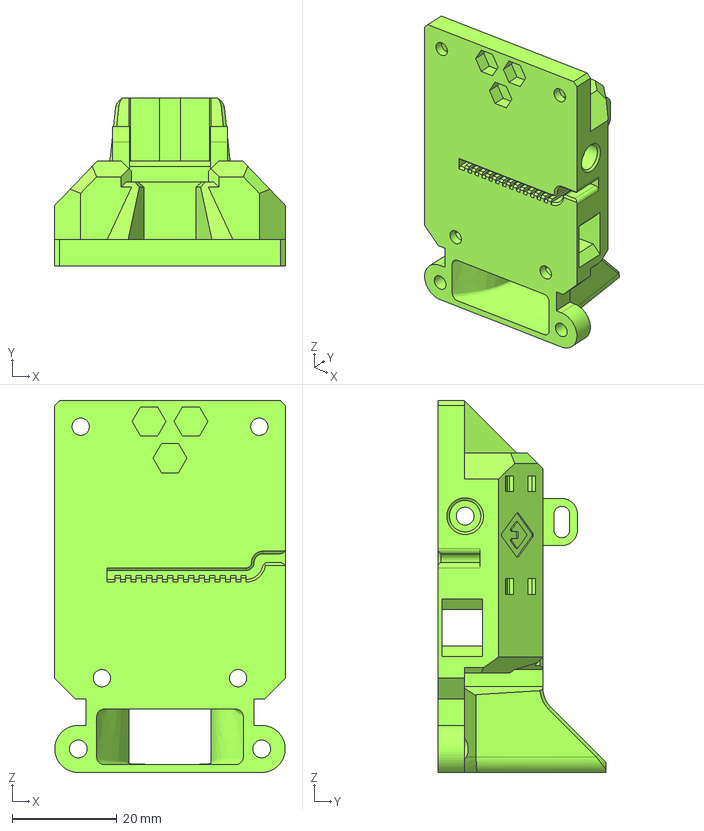
[picture p90: CAD file, 2021-12-29]
cad/printed_parts/machine/step/back_cartesian.step
44.1 x 32.0 x 71.0 mm
