Rat-Rig/V-Minion/cad/printed_parts/machine/step/pillow_block.step

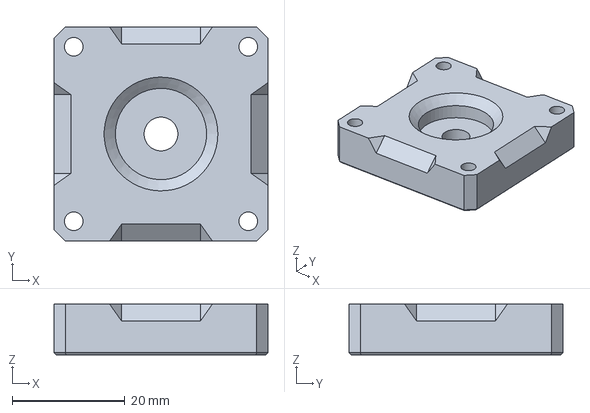
[picture p91: CAD file, 2021-12-29]
cad/printed_parts/machine/step/pillow_block.step
38.0 x 38.0 x 9.00 mm
