Rat-Rig/V-Minion/cad/printed_parts/machine/step/bed_wire_guide_start.step

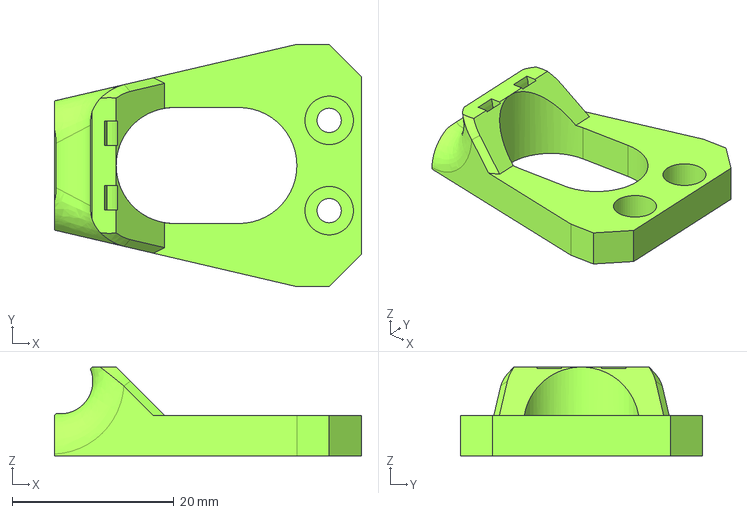
[picture p92: CAD file, 2021-12-29]
cad/printed_parts/machine/step/bed_wire_guide_start.step
38.0 x 30.0 x 11.0 mm
