Rat-Rig/V-Minion/cad/printed_parts/machine/step/top_endstop_angled.step

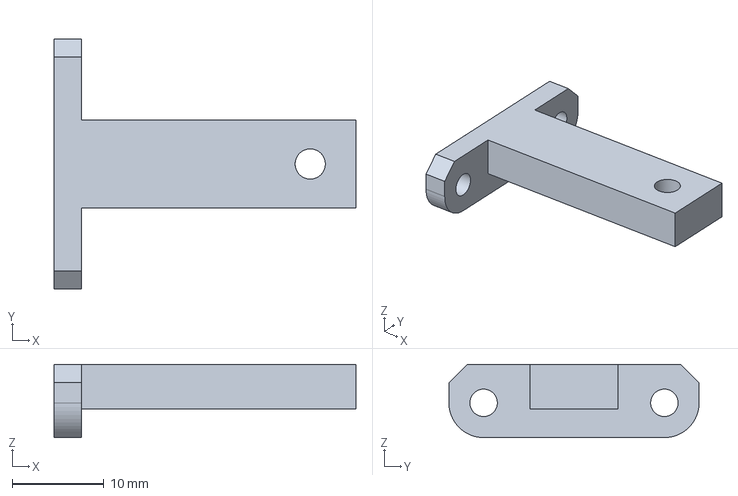
[picture p93: CAD file, 2021-12-29]
cad/printed_parts/machine/step/top_endstop_angled.step
33.0 x 27.3 x 8.00 mm
