Rat-Rig/V-Minion/cad/printed_parts/machine/step/cartesian_cable_fin.step

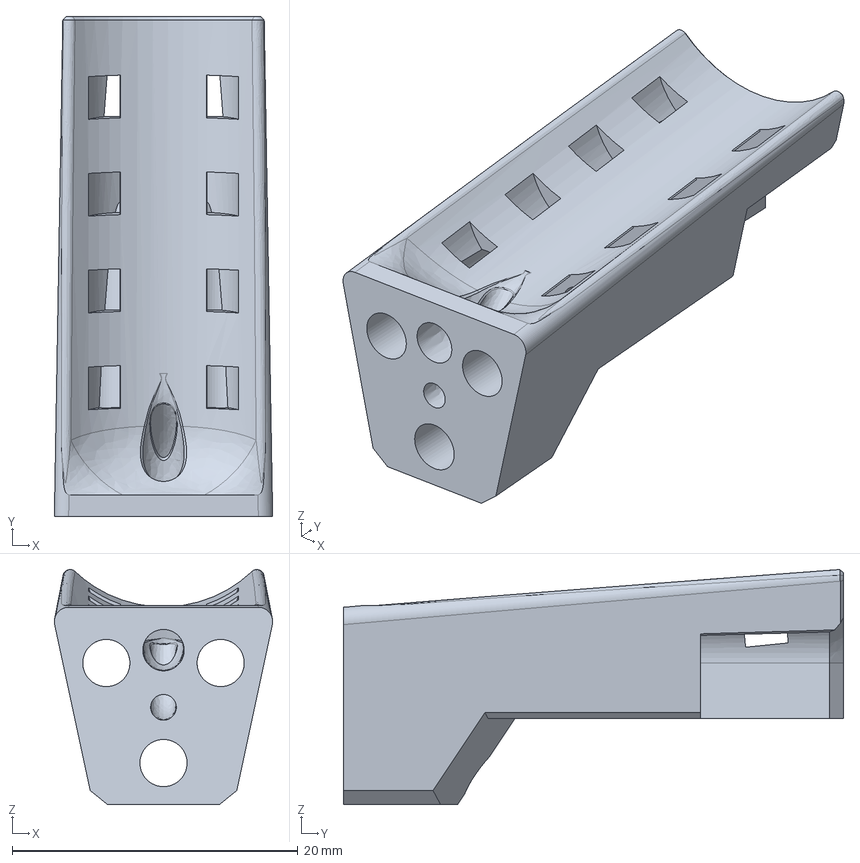
[picture p94: CAD file, 2021-12-29]
cad/printed_parts/machine/step/cartesian_cable_fin.step
15.3 x 35.0 x 16.4 mm
