Rat-Rig/V-Minion/cad/printed_parts/machine/step/top_mgn12.step

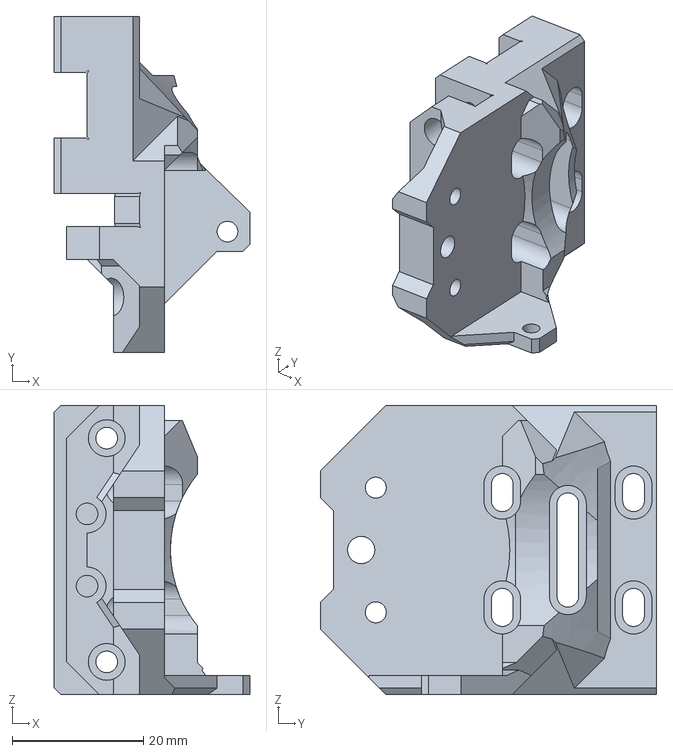
[picture p95: CAD file, 2021-12-29]
cad/printed_parts/machine/step/top_mgn12.step
29.8 x 51.2 x 44.1 mm
