Rat-Rig/V-Minion/cad/printed_parts/machine/step/bed_wire_guide_end.step

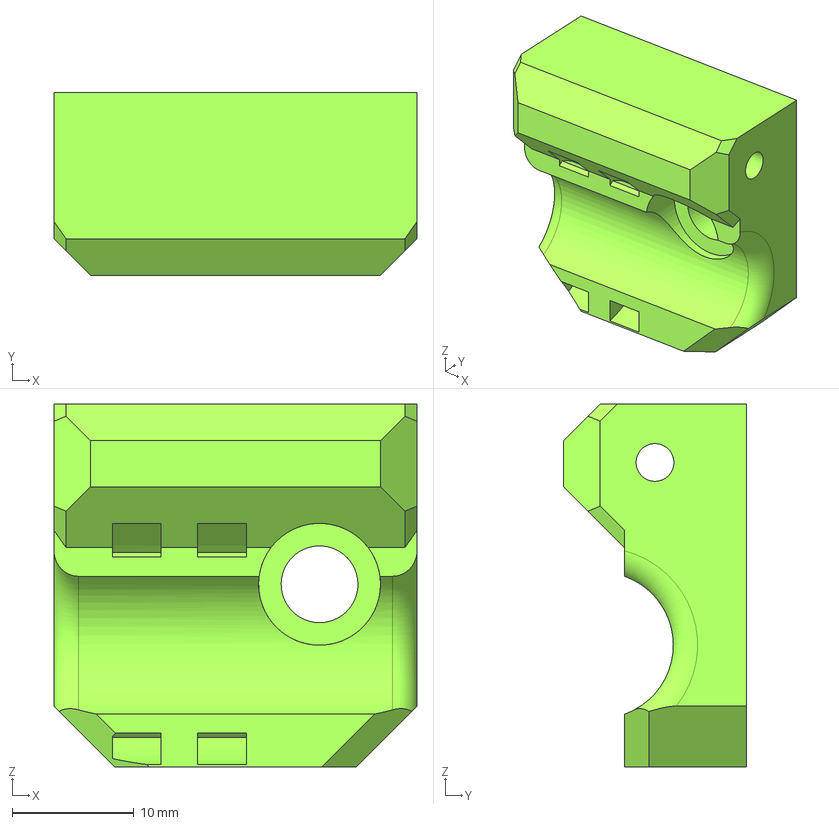
[picture p96: CAD file, 2021-12-29]
cad/printed_parts/machine/step/bed_wire_guide_end.step
29.8 x 15.0 x 29.8 mm
