Rat-Rig/V-Minion/cad/printed_parts/machine/step/y_belt_mount.step

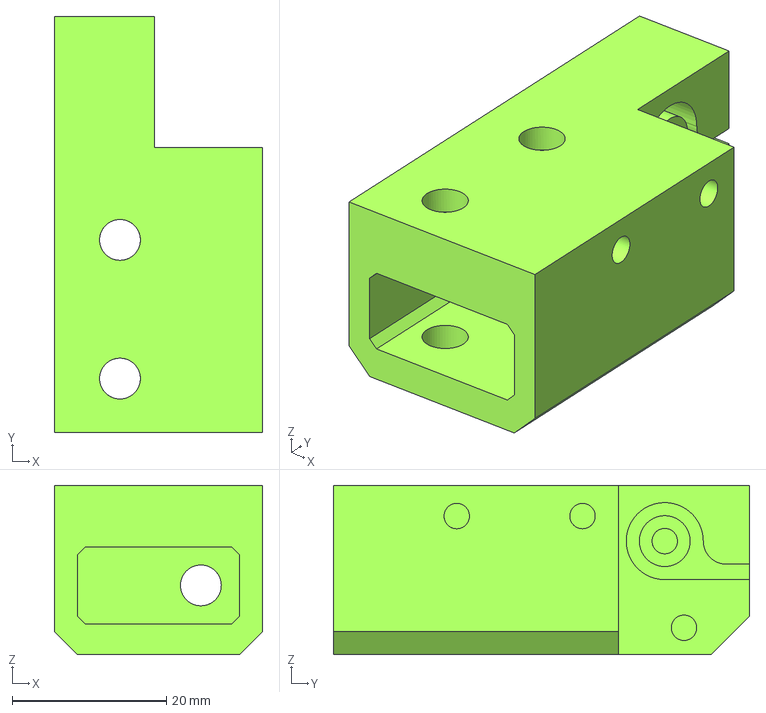
[picture p97: CAD file, 2021-12-29]
cad/printed_parts/machine/step/y_belt_mount.step
27.0 x 54.0 x 22.0 mm
