Rat-Rig/V-Minion/cad/printed_parts/machine/step/z_motor_cage.step

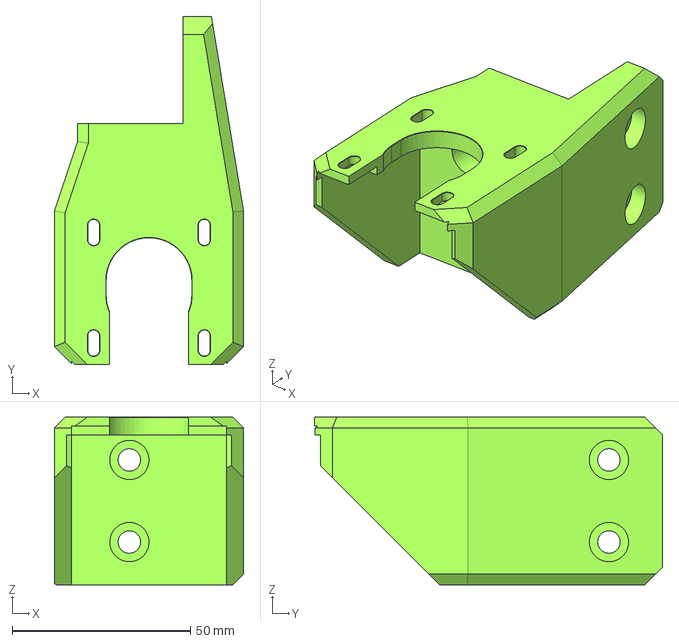
[picture p98: CAD file, 2021-12-29]
cad/printed_parts/machine/step/z_motor_cage.step
53.0 x 97.5 x 47.0 mm
