Rat-Rig/V-Minion/cad/printed_parts/machine/step/z_cap.step

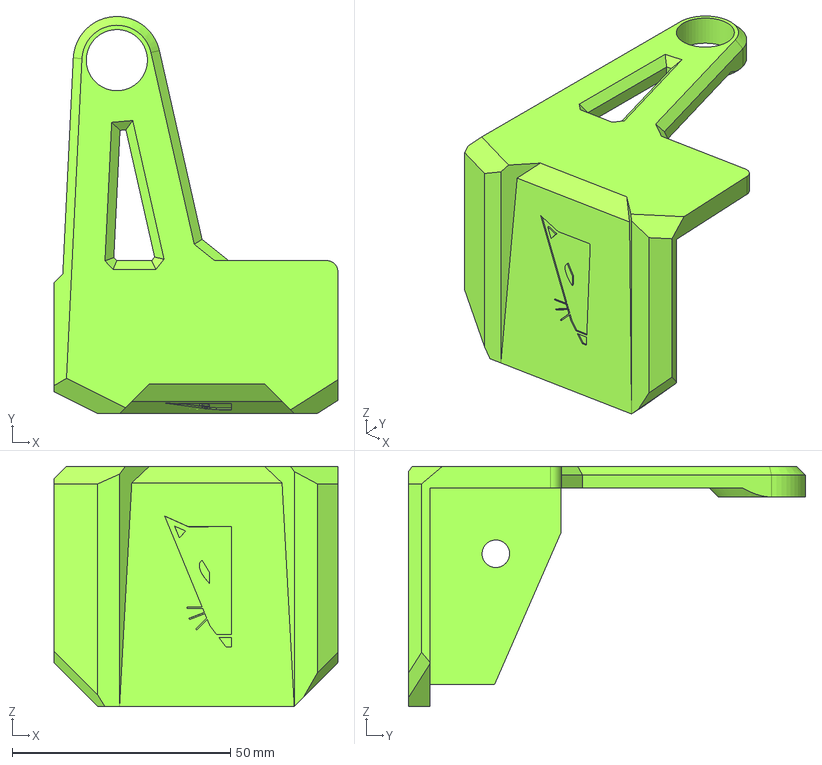
[picture p99: CAD file, 2021-12-29]
cad/printed_parts/machine/step/z_cap.step
65.0 x 90.9 x 55.0 mm
