Rat-Rig/V-Minion/cad/printed_parts/machine/step/y_endstop_mount.step

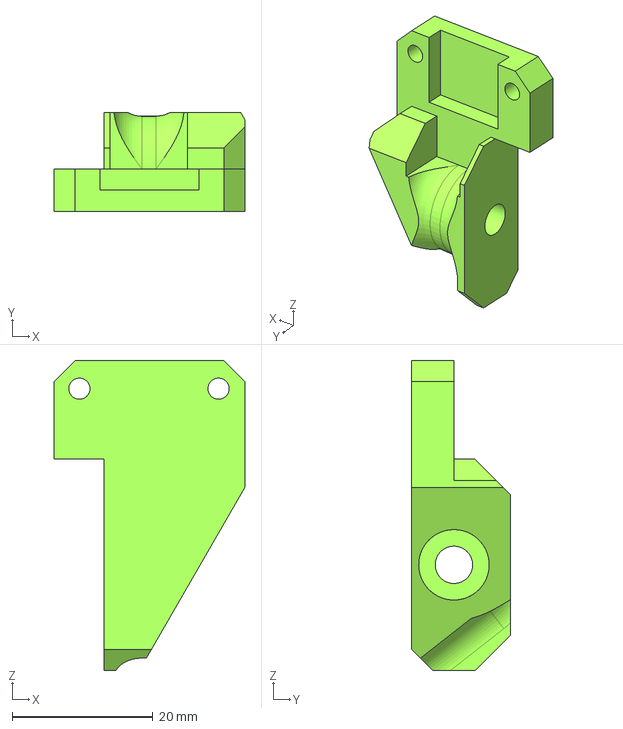
[picture p100: CAD file, 2021-12-29]
cad/printed_parts/machine/step/y_endstop_mount.step
27.1 x 14.0 x 44.0 mm
