Rat-Rig/V-Minion/cad/printed_parts/machine/step/LJ8_probe_mount_8mm.step

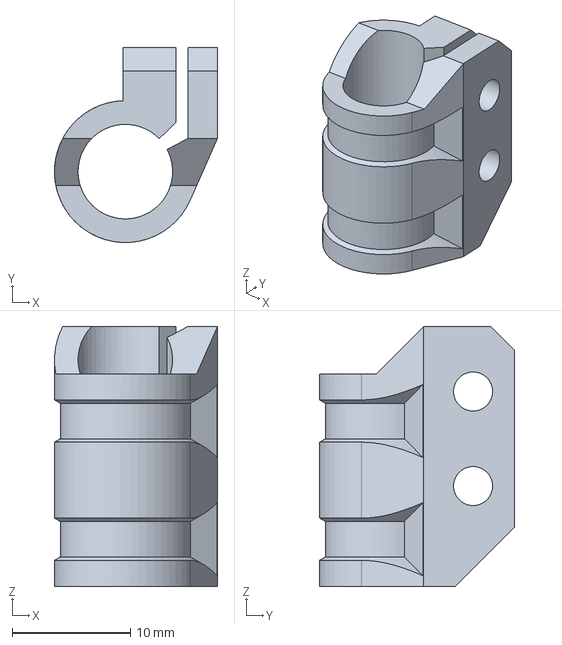
[picture p101: CAD file, 2021-12-29]
cad/printed_parts/machine/step/LJ8_probe_mount_8mm.step
13.8 x 16.5 x 22.0 mm
