Rat-Rig/V-Minion/cad/printed_parts/machine/step/y_belt_cover.step

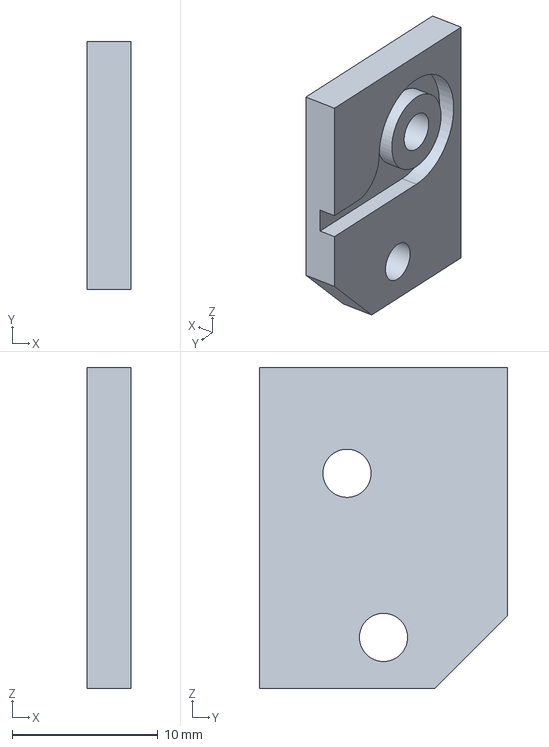
[picture p102: CAD file, 2021-12-29]
cad/printed_parts/machine/step/y_belt_cover.step
3.00 x 17.0 x 22.0 mm
