Rat-Rig/V-Minion/cad/printed_parts/machine/step/x_idler.step

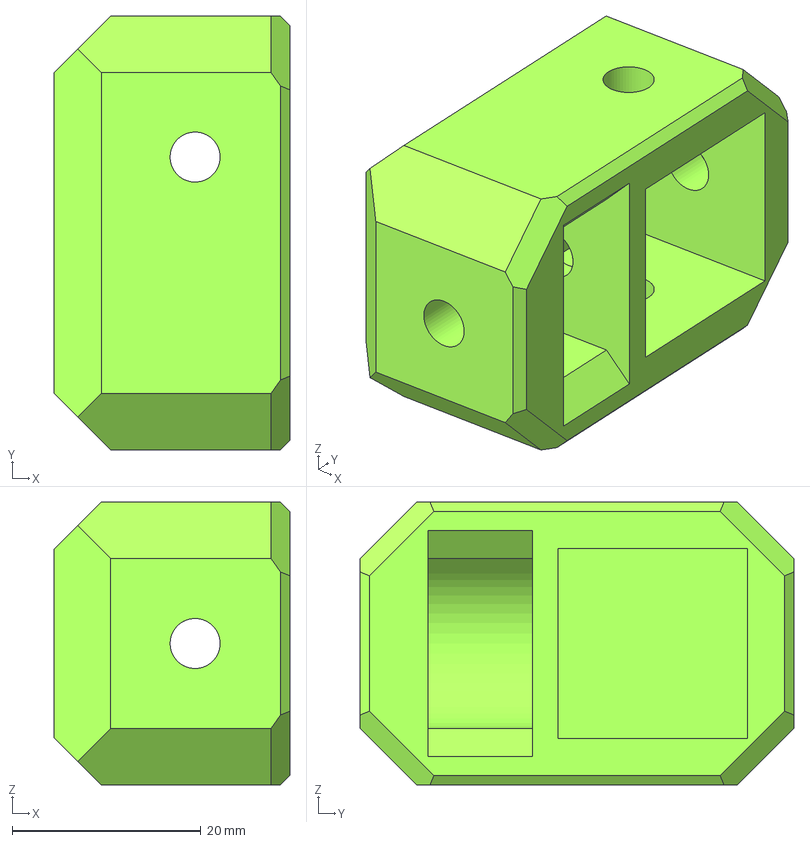
[picture p103: CAD file, 2021-12-29]
cad/printed_parts/machine/step/x_idler.step
25.0 x 46.0 x 30.0 mm
