Rat-Rig/V-Minion/cad/printed_parts/machine/step/z_motor_cage_plug.step

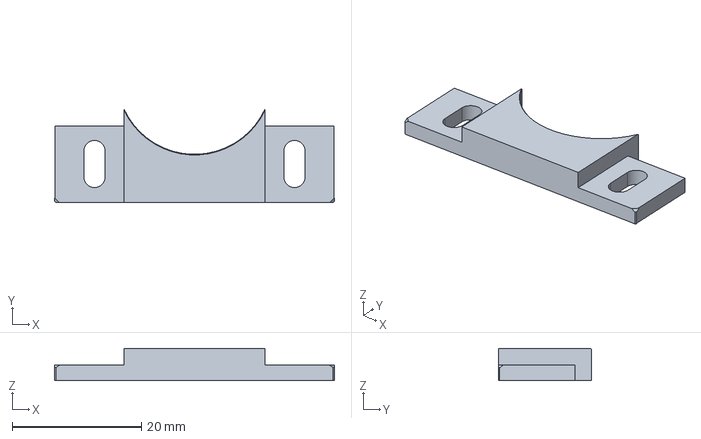
[picture p104: CAD file, 2021-12-29]
cad/printed_parts/machine/step/z_motor_cage_plug.step
43.4 x 14.5 x 5.00 mm
