Rat-Rig/V-Minion/cad/printed_parts/machine/step/side_legs.step

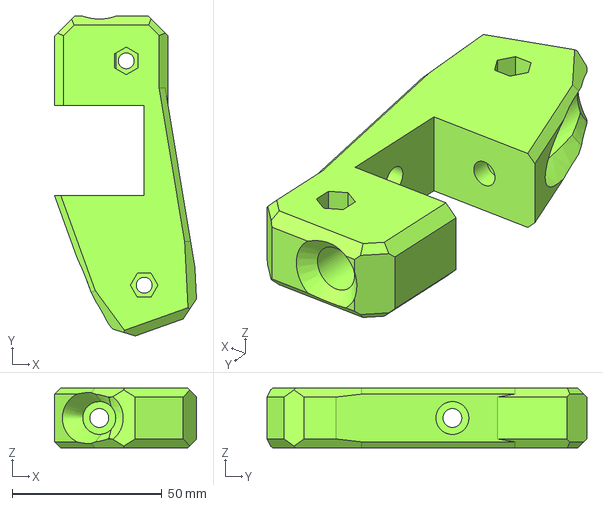
[picture p105: CAD file, 2021-12-29]
cad/printed_parts/machine/step/side_legs.step
47.5 x 107.0 x 20.0 mm
