Rat-Rig/V-Minion/cad/printed_parts/machine/step/y_idler.step

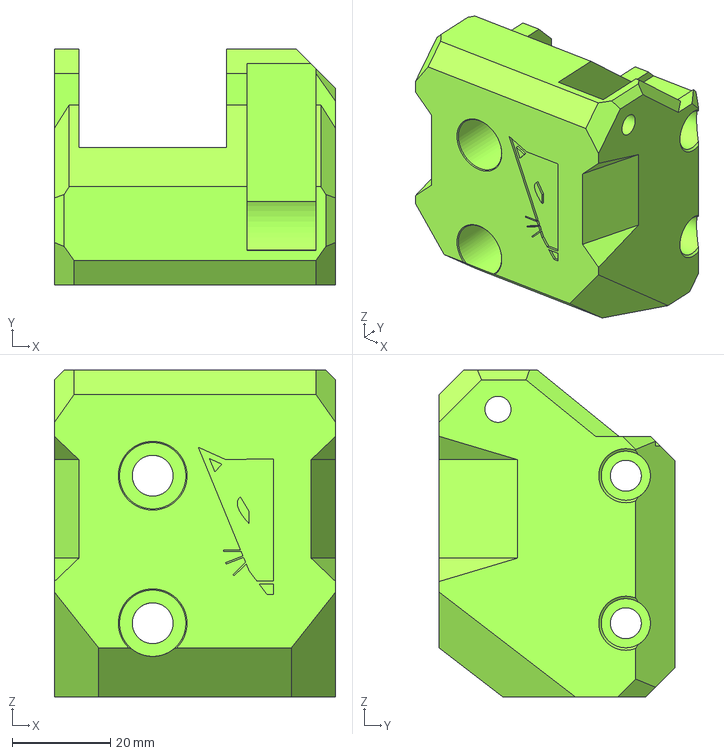
[picture p106: CAD file, 2021-12-29]
cad/printed_parts/machine/step/y_idler.step
57.2 x 48.0 x 66.5 mm
