Rat-Rig/V-Minion/cad/printed_parts/machine/step/bottom_mgn12_short_duct.step

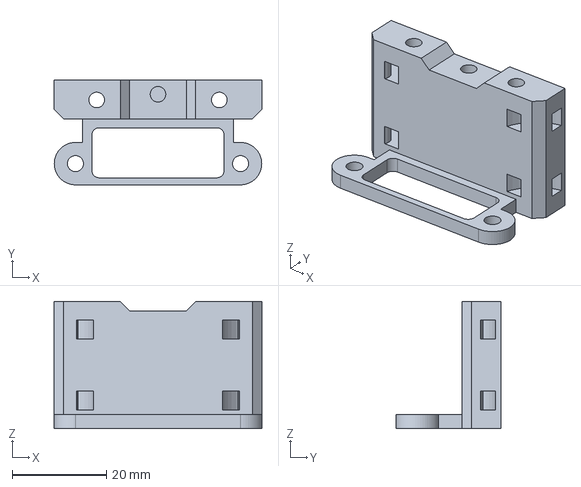
[picture p107: CAD file, 2021-12-29]
cad/printed_parts/machine/step/bottom_mgn12_short_duct.step
44.1 x 22.2 x 27.0 mm
