Rat-Rig/V-Minion/cad/printed_parts/machine/step/x_wire_holder.step

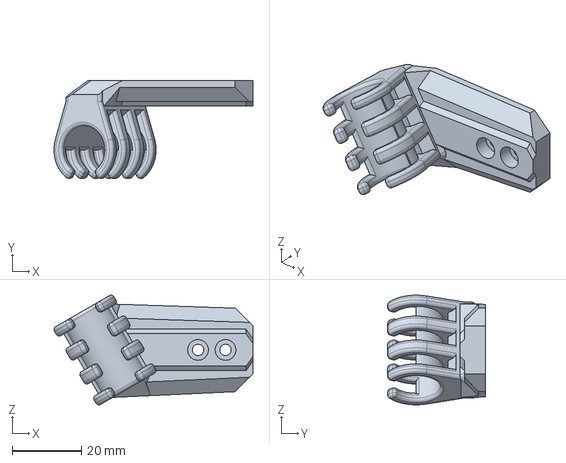
[picture p108: CAD file, 2021-12-29]
cad/printed_parts/machine/step/x_wire_holder.step
57.6 x 28.2 x 31.8 mm
