Rat-Rig/V-Minion/(list of files, cad)

Other CAD files:
cad/panels/STEP/Metric/panel_electronics_psu_v1.0.step
cad/panels/STL/panel_electronics_psu_v1.0.stl
cad/panels/STEP/Imperial/panel_electronics_board_v1.0.step
cad/panels/STEP/Imperial/panel_electronics_top_v1.0.step
cad/panels/STEP/Metric/panel_electronics_base_v1.0.step
cad/panels/STL/panel_electronics_board_v1.0.stl
cad/panels/STEP/Imperial/panel_electronics_base_v1.0.step
cad/panels/STEP/Metric/panel_electronics_board_v1.0.step
cad/panels/STL/panel_electronics_top_v1.0.stl
cad/panels/DXF/Imperial/panel_electronics_base_v1.0.dxf
cad/panels/DXF/Imperial/panel_electronics_board_v1.0.dxf
cad/panels/DXF/Imperial/panel_electronics_psu_v1.0.dxf
cad/panels/DXF/Imperial/panel_electronics_top_v1.0.dxf
cad/panels/DXF/Metric/panel_electronics_base_v1.0.dxf
cad/panels/DXF/Metric/panel_electronics_board_v1.0.dxf
cad/panels/DXF/Metric/panel_electronics_psu_v1.0.dxf
cad/panels/DXF/Metric/panel_electronics_top_v1.0.dxf
cad/printed_parts/elecronics_case/stl/40mm_fan_cage.stl
cad/printed_parts/elecronics_case/stl/case_back.stl
cad/printed_parts/elecronics_case/stl/case_feet.stl
cad/printed_parts/elecronics_case/stl/case_front.stl
cad/printed_parts/elecronics_case/stl/case_wire_holder.stl
cad/printed_parts/elecronics_case/stl/case_wire_passthrough.stl
cad/printed_parts/machine/stl/3030 Spool Holder Mount.stl
cad/printed_parts/machine/stl/3030_end_cap.stl
cad/printed_parts/machine/stl/LJ8_probe_mount_8mm.stl
cad/printed_parts/machine/stl/back_cartesian.stl
cad/printed_parts/machine/stl/bed_wire_guide_end.stl
cad/printed_parts/machine/stl/bed_wire_guide_start.stl
cad/printed_parts/machine/stl/bmo_face.stl
cad/printed_parts/machine/stl/bmo_support.stl
cad/printed_parts/machine/stl/bottom_mgn12_short_duct.stl
cad/printed_parts/machine/stl/cartesian_cable_fin.stl
cad/printed_parts/machine/stl/pillow_block.stl
cad/printed_parts/machine/stl/ratrig_eva_shroud.stl
cad/printed_parts/machine/stl/side_legs.stl
cad/printed_parts/machine/stl/tension_slider_6mm_belt_M3s.stl
cad/printed_parts/machine/stl/top_endstop_angled.stl
cad/printed_parts/machine/stl/top_mgn12.stl
cad/printed_parts/machine/stl/universal_face.stl
cad/printed_parts/machine/stl/x_gantry_end_cap.stl
cad/printed_parts/machine/stl/x_idler.stl
cad/printed_parts/machine/stl/x_motor_cage.stl
cad/printed_parts/machine/stl/x_wire_holder.stl
cad/printed_parts/machine/stl/y_belt_cover.stl
cad/printed_parts/machine/stl/y_belt_mount.stl
cad/printed_parts/machine/stl/y_belt_tensioner.stl
cad/printed_parts/machine/stl/y_endstop_mount.stl
cad/printed_parts/machine/stl/y_idler.stl
cad/printed_parts/machine/stl/y_motor_cage.stl
cad/printed_parts/machine/stl/z_cap.stl
cad/printed_parts/machine/stl/z_motor_cage.stl
cad/printed_parts/machine/stl/z_motor_cage_plug.stl
