Rat-Rig/V-Minion/docs/src/assets/wiring_skrat.png

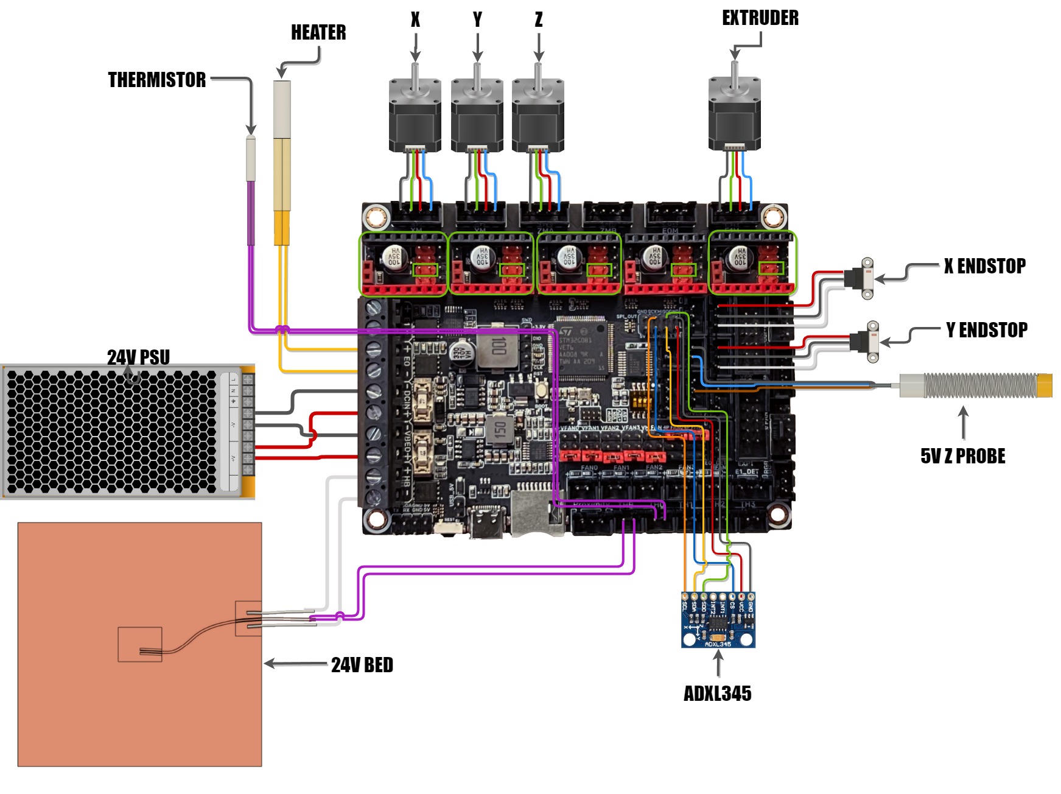
docs/src/assets/wiring_skrat.png
