Rat-Rig/V-Minion/docs/src/assets/wiring_skrat_fan.png

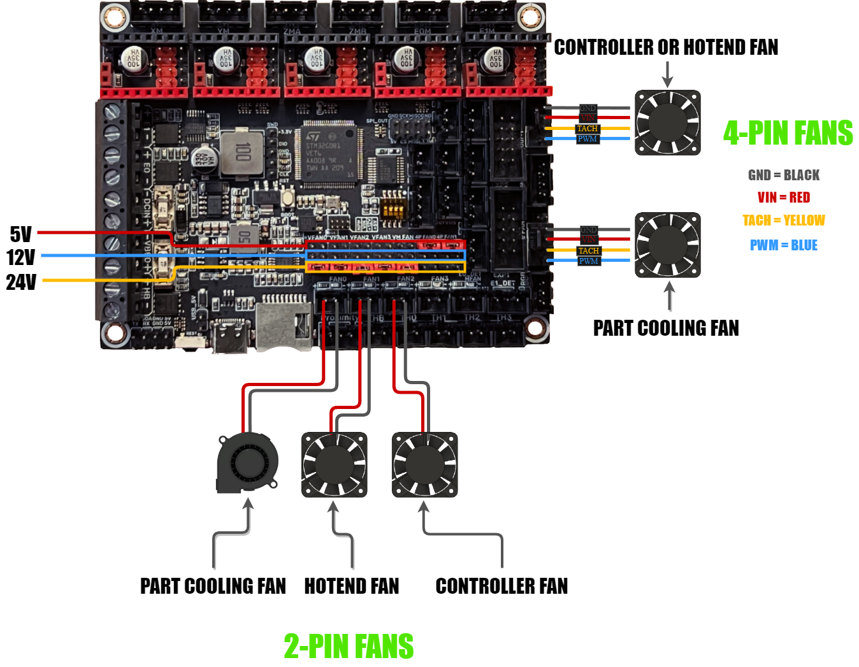
docs/src/assets/wiring_skrat_fan.png
