Rat-Rig/V-Minion/(threads)

Thread 5 (2022-01-26):

Incorrect orientation of tension_slider_6mm_belt_M3s.stl

rjorgenson, 2022-01-26:
On the V-Minion web page it has 3d picture showing the orientation of all the parts. The orientation for the tension_slider_6mm_belt_M3s.stl part appears to be incorrect and differs from the orientation on the EVA site.

https://v-minion.ratrig.com/printed_parts/#printed-parts-orientation:
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

EVA image came from a screenshot on discord. Not sure where that information is actually posted.

Thread 6 (2022-01-27):

Some STL part orientations are not appropriate for printing

darraghbr, 2022-01-27:
Some of the stls are in the correct orientation for printing and some of them are not, this is a very small issue but would be nicer if they were all correct from the repo.
