Rat-Rig/V-Minion/docs/src/assets/magnetic_sheet_template_v1.1.pdf

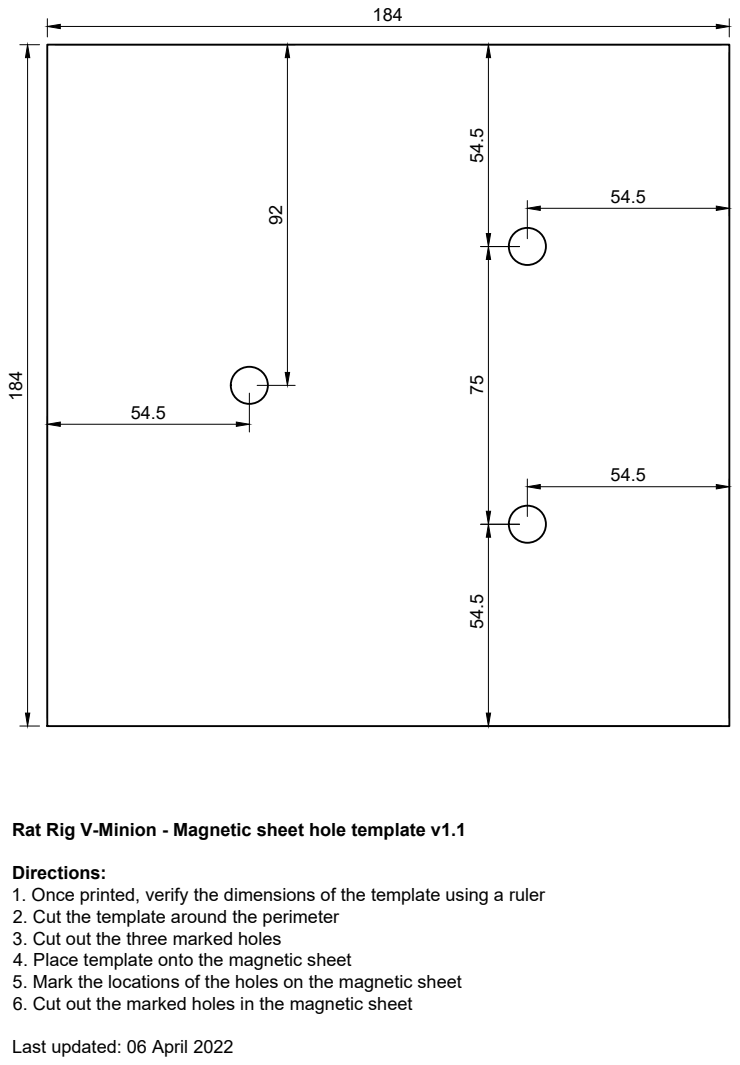
[picture p111: page 1]

Rat Rig V-Minion - Magnetic sheet hole template v1.1

Directions:
1. Once printed, verify the dimensions of the template using a ruler
2. Cut the template around the perimeter
3. Cut out the three marked holes
4. Place template onto the magnetic sheet
5. Mark the locations of the holes on the magnetic sheet
6. Cut out the marked holes in the magnetic sheet

Last updated: 06 April 2022
