Rat-Rig/V-Minion/(commit log)

2021-12-26 Initial V-Minion Commit
    [electronics.csv, full_bom.csv, printed_parts.csv]
2021-12-29 squash git history for the release
    [40mm_fan_cage.step, 40mm_fan_cage.stl, LJ8_probe_mount_8mm.step, LJ8_probe_mount_8mm.stl, TriHorn Duct.step, back_cartesian.step, back_cartesian.stl, bed_wire_guide_end.step]
2021-12-30 add 3030 endcap files
    [3030 Spool Holder Mount.step, 3030 Spool Holder Mount.stl, 3030_end_cap.step, 3030_end_cap.stl, machine.json]
2022-01-12 Add sample print images
2022-01-16 Update BTT SKR2 wiring diagram
2022-01-18 Update BTT SKR2 wiring diagram again
    Mikkel missed a jumper required for the ADXL345 connection
2022-01-20 Add Raspberry Pi power wiring diagram
2022-02-09 Update BOM
    [vminion_08022002_1225.csv]
2022-02-11 Add electronics enclosure panels
    DXF, STEP and STL files are provided. Metric & imperial for DXF and STEP. Metric only for the STL files.
    [panel_electronics_base_v1.0.dxf, panel_electronics_base_v1.0.step, panel_electronics_base_v1.0.stl, panel_electronics_board_v1.0.dxf, panel_electronics_board_v1.0.step, panel_electronics_board_v1.0.stl, panel_electronics_psu_v1.0.dxf, panel_electronics_psu_v1.0.step]
2022-02-11 Update printed_parts.md
    Add electronics panels section
2022-02-18 Add PDF template for magnetic sheet holes
2022-02-23 Add printable electronics panels to BOM
2022-02-24 Remove essentials kit from BOM
    [vminion_08022002_1225.csv]
2022-03-15 Add repo download to BOM
    Also fix broken download icon on files & printing
2022-03-18 Add Sample Print 3
2022-04-06 Update magnetic_sheet_template to v1.1
2022-04-25 Update CAD URL to Fusion 360
2022-06-02 Add BTT Octopus 1.1 Wiring Diagram
2022-06-03 Update EVA Version on BOM
2022-08-26 Update community.md
    Swap out material icons due to occasional rendering issue
2022-10-20 Update shroud design
    [machine.json, ratrig_eva_shroud.step, ratrig_eva_shroud.stl, shroud.step, shroud.stl]
2022-10-21 Update BOM - RPi Shortage
    [vminion_21102022_1542.csv]
2022-12-07 Update V-Minion BOM
    Remove packing SKU
    [vminion_07122022_0906.csv]
2022-12-12 Update RPi information on BOM.md
2022-12-19 Update V-Minion BOM
    [vminion_09122022_0939.csv]
2023-04-03 Add wiring diagrams for SKRat 1.0
2023-04-03 Remove mkdocs-material-insiders
2023-04-20 Update default kit & BOM for BTT SKRat v1.0
    [vminion_20042023_1212.csv]
